Cyprus-Subsea/Smart-Cable-2-Hardware/modules/MCU/V1/VERSIONS.txt

α1:
Bugs:
1. Pin 26 connected to GND, should be VCC2_OUT.
