Cyprus-Subsea/Smart-Cable-2-Hardware/PINOUTS.xlsx

Sheet: STM32_CASES
 |  |  |  | PB9 | PB8 | PH3 | PB7 | PB6 | PB5 | PB4 | PB3 |  |  |  |  |  |  |  |  |  |  |  |  |  |  |  |  |  |  | PA15 | PA14
 |  |  |  | PB9 | PB8 | PH3 | PB7 | PB6 | PB5 | PB4 | PB3 |  |  |  |  |  |  |  |  |  |  |  |  |  |  | PD2 | PC12 | PC11 | PC10 | PA15 | PA14 |  |  |  |  | 144
 |  | PE1 | PE0 | PB9 | PB8 | PH3 | PB7 | PB6 | PB5 | PB4 | PB3 |  |  |  |  |  |  |  | PD7 | PD6 | PD5 | PD4 | PD3 | PD2 | PD1 | PD0 | PC12 | PC11 | PC10 | PA15 | PA14 |  |  |  |  | 100
 |  | PE1 | PE0 | PB9 | PB8 | PH3 | PB7 | PB6 | PB5 | PB4 | PB3 | PG15 | PG14 | PG13 | PG12 | PG11 | PG10 | PG9 | PD7 | PD6 | PD5 | PD4 | PD3 | PD2 | PD1 | PD0 | PC12 | PC11 | PC10 | PA15 | PA14 |  |  |  |  | 64
 |  |  |  |  |  |  |  |  |  |  |  |  |  |  |  |  |  |  |  |  |  |  |  |  |  |  |  |  |  |  |  | PA13 | PA13 | PA13 | PA13 | 48
 |  | PE2 | PE2 |  |  |  |  |  |  |  |  |  |  |  |  |  |  |  |  |  |  |  |  |  |  |  |  |  |  |  |  | PA12 | PA12 | PA12 | PA12
 |  | PE3 | PE3 |  |  |  |  |  |  |  |  |  |  |  |  |  |  |  |  |  |  |  |  |  |  |  |  |  |  |  |  | PA11 | PA11 | PA11 | PA11
 |  | PE4 | PE4 |  |  |  |  |  |  |  |  |  |  |  |  |  |  |  |  |  |  |  |  |  |  |  |  |  |  |  |  | PA10 | PA10 | PA10 | PA10
 |  | PE5 | PE5 |  |  |  |  |  |  |  |  |  |  |  |  |  |  |  |  |  |  |  |  |  |  |  |  |  |  |  |  | PA9 | PA9 | PA9 | PA9
 |  | PE6 | PE6 |  |  |  |  |  |  |  |  |  |  |  |  |  |  |  |  |  |  |  |  |  |  |  |  |  |  |  |  | PA8 | PA8 | PA8 | PA8
PC13 | PC13 | PC13 | PC13 |  |  |  |  |  |  |  |  |  |  |  |  |  |  |  |  |  |  |  |  |  |  |  |  |  |  |  |  | PC9 | PC9 | PC9
PC14 | PC14 | PC14 | PC14 |  |  |  |  |  |  |  |  |  |  |  |  |  |  |  |  |  |  |  |  |  |  |  |  |  |  |  |  | PC8 | PC8 | PC8
PC15 | PC15 | PC15 | PC15 |  |  |  |  |  |  |  |  |  |  |  |  |  |  |  |  |  |  |  |  |  |  |  |  |  |  |  |  | PC7 | PC7 | PC7
 |  |  | PF0 |  |  |  |  |  |  |  |  |  |  |  |  |  |  |  |  |  |  |  |  |  |  |  |  |  |  |  |  | PC6 | PC6 | PC6
 |  |  | PF1 |  |  |  |  |  |  |  |  |  |  |  |  |  |  |  |  |  |  |  |  |  |  |  |  |  |  |  |  | PG8
 |  |  | PF2 |  |  |  |  |  |  |  |  |  |  |  |  |  |  |  |  |  |  |  |  |  |  |  |  |  |  |  |  | PG7
 |  |  | PF3 |  |  |  |  |  |  |  |  |  |  |  |  |  |  |  |  |  |  |  |  |  |  |  |  |  |  |  |  | PG6
 |  |  | PF4 |  |  |  |  |  |  |  |  |  |  | STM32_LQFP CASES |  |  |  |  |  |  |  |  |  |  |  |  |  |  |  |  |  | PG5
 |  |  | PF5 |  |  |  |  |  |  |  |  |  |  |  |  |  |  |  |  |  |  |  |  |  |  |  |  |  |  |  |  | PG4
 |  |  | PF6 |  |  |  |  |  |  |  |  |  |  |  |  |  |  |  |  |  |  |  |  |  |  |  |  |  |  |  |  | PG3
 |  |  | PF7 |  |  |  |  |  |  |  |  |  |  |  |  |  |  |  |  |  |  |  |  |  |  |  |  |  |  |  |  | PG2
 |  |  | PF8 |  |  |  |  |  |  |  |  |  |  |  |  |  |  |  |  |  |  |  |  |  |  |  |  |  |  |  |  | PD15 | PD15
 |  |  | PF9 |  |  |  |  |  |  |  |  |  |  |  |  |  |  |  |  |  |  |  |  |  |  |  |  |  |  |  |  | PD14 | PD14
 |  |  | PF10 |  |  |  |  |  |  |  |  |  |  |  |  |  |  |  |  |  |  |  |  |  |  |  |  |  |  |  |  | PD13 | PD13
PH0 | PH0 | PH0 | PH0 |  |  |  |  |  |  |  |  |  |  |  |  |  |  |  |  |  |  |  |  |  |  |  |  |  |  |  |  | PD12 | PD12
PH1 | PH1 | PH1 | PH1 |  |  |  |  |  |  |  |  |  |  |  |  |  |  |  |  |  |  |  |  |  |  |  |  |  |  |  |  | PD11 | PD11
 | PC0 | PC0 | PC0 |  |  |  |  |  |  |  |  |  |  |  |  |  |  |  |  |  |  |  |  |  |  |  |  |  |  |  |  | PD10 | PD10
 | PC1 | PC1 | PC1 |  |  |  |  |  |  |  |  |  |  |  |  |  |  |  |  |  |  |  |  |  |  |  |  |  |  |  |  | PD9 | PD9
 | PC2 | PC2 | PC2 |  |  |  |  |  |  |  |  |  |  |  |  |  |  |  |  |  |  |  |  |  |  |  |  |  |  |  |  | PD8 | PD8
 | PC3 | PC3 | PC3 |  |  |  |  |  |  |  |  |  |  |  |  |  |  |  |  |  |  |  |  |  |  |  |  |  |  |  |  | PB15 | PB15 | PB15 | PB15
PA0 | PA0 | PA0 | PA0 |  |  |  |  |  |  |  |  |  |  |  |  |  |  |  |  |  |  |  |  |  |  |  |  |  |  |  |  | PB14 | PB14 | PB14 | PB14
PA1 | PA1 | PA1 | PA1 |  |  |  |  |  |  |  |  |  |  |  |  |  |  |  |  |  |  |  |  |  |  |  |  |  |  |  |  | PB13 | PB13 | PB13 | PB13
PA2 | PA2 | PA2 | PA2 |  |  |  |  |  |  |  |  |  |  |  |  |  |  |  |  |  |  |  |  |  |  |  |  |  |  |  |  | PB12 | PB12 | PB12 | PB12
 |  |  |  | PA3 | PA4 | PA5 | PA6 | PA7 | PC4 | PC5 | PB0 | PB1 | PB2 | PF11 | PF12 | PF13 | PF14 | PF15 | PG0 | PG1 | PE7 | PE8 | PE9 | PE10 | PE11 | PE12 | PE13 | PE14 | PE15 | PB10 | PB11
 |  |  |  | PA3 | PA4 | PA5 | PA6 | PA7 | PC4 | PC5 | PB0 | PB1 | PB2 |  |  |  |  |  |  |  | PE7 | PE8 | PE9 | PE10 | PE11 | PE12 | PE13 | PE14 | PE15 | PB10 | PB11
 |  |  |  | PA3 | PA4 | PA5 | PA6 | PA7 | PC4 | PC5 | PB0 | PB1 | PB2 |  |  |  |  |  |  |  |  |  |  |  |  |  |  |  |  | PB10 | PB11
 |  |  |  | PA3 | PA4 | PA5 | PA6 | PA7 |  |  | PB0 | PB1 | PB2 |  |  |  |  |  |  |  |  |  |  |  |  |  |  |  |  | PB10 | PB11

Sheet: STM32L552_PINS
MCU α1 | MB α1 |  | Analog,additional function | USART1/2/3 | UART4/5/LPUA RT1/SDMMC1 | I2C1/2/3/4 | SPI1/2/3/I2C4/ DFSDM1/ OCTOSPI1 | SPI3/I2C3/DFS DM1/COMP1/ | SPI2/SAI1/I2C4/ USART2/TIM1/8/ OCTOSPI1 | FDCAN1/ TSC | USB/OCTOSPI1 | TIM2/8/15/16/17/ LPTIM2 | TIM1/2/5/8/L PTIM1 | TIM1/2/3/4/5/ LPTIM3 | SAI1/2/TIM8 | SDMMC1/COMP1 /2/TIM1/8/FMC | UCPD1 | SYS_AF | EVENTOUT
89 | H5_6 | PA0 | ADC,WKP1 TAMP,OAMP1_INP | USART2_CTS_ NSS | UART4_TX | - | - | - | TIM8_ETR | - | - | TIM2_ETR | TIM2_CH1 | TIM5_CH1 | SAI1_EXTCLK | - | - | - | EVENTOUT | H2_6 | H3_6 | H4_6 | H5_6
88 | H5_7 | PA1 | ADC,WKP1 TAMP,OAMP1_INM | USART2_RTS_ DE | UART4_RX | I2C1_SMBA | SPI1_SCK | - | - | - | OCTOSPI1_DQS | TIM15_CH1N | TIM2_CH2 | TIM5_CH2 | - | - | - | - | EVENTOUT | H2_7 | H3_7 | H4_7 | H5_7
87 | H2_6 | PA2 | ADC,WKP,COMP1_INP | USART2_TX | LPUART1_TX | - | - | - | - | - | OCTOSPI1_NCS | TIM15_CH1 | TIM2_CH3 | TIM5_CH3 | SAI2_EXTCLK | - | UCPD1_FRSTX1 | - | EVENTOUT
86 | H2_7 | PA3 | ADC,OPAMP1_OUT | USART2_RX | LPUART1_RX | - | - | - | SAI1_CK1 | - | OCTOSPI1_CLK | TIM15_CH2 | TIM2_CH4 | TIM5_CH4 | SAI1_MCLK_A | - | - | - | EVENTOUT | H2_15 | H3_15 | H4_15 | H5_15
85 | H2_19 | PA4 | ADC,DAC_OUT1 | USART2_CK | - | - | SPI1_NSS | SPI3_NSS | OCTOSPI1_NCS | - | - | LPTIM2_OUT | - | - | SAI1_FS_B | - | - | - | EVENTOUT | H2_16 | H3_16 | H4_16 | H5_16
84 | H2-5_12 | PA5 | ADC,DAC_OUT2 | - | - | - | SPI1_SCK | - | TIM8_CH1N | - | - | LPTIM2_ETR | TIM2_CH1 | TIM2_ETR | - | - | - | - | EVENTOUT | H2_17 | H3_17 | H4_17 | H5_17
83 | H2-5_13 | PA6 | ADC,OPAMP2_VINP | USART3_CTS_ NSS | LPUART1_CTS _NSS | - | SPI1_MISO | - | TIM8_BKIN | - | OCTOSPI1_IO3 | TIM16_CH1 | TIM1_BKIN | TIM3_CH1 | TIM8_BKIN | TIM1_BKIN | - | - | EVENTOUT | H2_18 | H3_18 | H4_18 | H5_18
82 | H2-5_14 | PA7 | ADC,OPAMP2_VINM | - | - | I2C3_SCL | SPI1_MOSI | - | TIM8_CH1N | - | OCTOSPI1_IO2 | TIM17_CH1 | TIM1_CH1N | TIM3_CH2 | - | - | - | - | EVENTOUT | H2_19 | H3_19 | H4_19 | H5_19
40 | H3_15 | PA8 |  | USART1_CK | - | - | - | - | SAI1_CK2 | - | - | LPTIM2_OUT | TIM1_CH1 | - | SAI1_SCK_A | - | - | MCO | EVENTOUT
39 | H4_6 | PA9 |  | USART1_TX | - | - | - | - | SPI2_SCK | - | - | TIM15_BKIN | TIM1_CH2 | - | SAI1_FS_A | - | - | - | EVENTOUT
38 | H4_7 | PA10 |  | USART1_RX | - | - | - | - | SAI1_D1 | - | CRS_SYNC | TIM17_BKIN | TIM1_CH3 | - | SAI1_SD_A | - | - | - | EVENTOUT
37 | H4_18 | PA11 |  | USART1_CTS_ NSS | - | - | SPI1_MISO | - | - | FDCAN1_ RX | USB_DM | - | TIM1_CH4 | TIM1_BKIN2 | - | TIM1_BKIN2 | - | - | EVENTOUT
36 | H4_19 | PA12 |  | USART1_RTS_ DE | - | - | SPI1_MOSI | - | - | FDCAN1_ TX | USB_DP | - | TIM1_ETR | - | - | - | - | - | EVENTOUT
35 |  | PA13 |  | - | - | - | - | - | - | - | USB_NOE | - | IR_OUT | - | SAI1_SD_B | - | - | JTMS/SWDIO | EVENTOUT
34 |  | PA14 |  | - | - | I2C1_SMBA | I2C4_SMBA | - | - | - | - | - | LPTIM1_OUT | - | SAI1_FS_B | - | - | JTCK/SWCLK | EVENTOUT
SD_CD1 |  | PA15 |  | USART3_RTS_ DE | UART4_RTS_D E | - | SPI1_NSS | SPI3_NSS | USART2_RX | - | - | - | TIM2_CH1 | TIM2_ETR | SAI2_FS_B | - | - | JTDI | EVENTOUT
79 | H2_15 | PB0 | ADC,OPAMP2_OUT | USART3_CK | - | - | SPI1_NSS | - | TIM8_CH2N | - | OCTOSPI1_IO1 | - | TIM1_CH2N | TIM3_CH3 | SAI1_EXTCLK | COMP1_OUT | - | - | EVENTOUT |  | H2-5_8 | H3-4_8 | H2-5_12 | H3-4_12
78 | H2_16 | PB1 | ADC,COMP1_INM | USART3_RTS_ DE | LPUART1_RTS_ DE | - | - | DFSDM1_DATI N0 | TIM8_CH3N | - | OCTOSPI1_IO0 | LPTIM2_IN1 | TIM1_CH3N | TIM3_CH4 | - | - | - | - | EVENTOUT |  | H2-5_9 | H3-4_9 | H2-5_13 | H3-4_13
77 |  | PB2 | RTC_OUT2,COMP1_INP | - | - | I2C3_SMBA | - | DFSDM1_CKI N0 | - | - | OCTOSPI1_DQS | - | LPTIM1_OUT | - | - | - | UCPD1_FRSTX1 | - | EVENTOUT |  |  |  | H2-5_14 | H3-4_14
17 | PWRM_I2C_PILLUP | PB3 | COMP2_INM | USART1_RTS_ DE | - | - | SPI1_SCK | SPI3_SCK | - | - | CRS_SYNC | - | TIM2_CH2 | - | SAI1_SCK_B | - | - | JTDO/TRACE SWO | EVENTOUT
16 |  | PB4 | COMP2_INP | USART1_CTS_ NSS | UART5_RTS_D E | I2C3_SDA | SPI1_MISO | SPI3_MISO | - | TSC_G2_ IO1 | - | TIM17_BKIN | - | TIM3_CH1 | SAI1_MCLK_B | - | - | NJTRST | EVENTOUT
15 |  | PB5 |  | USART1_CK | UART5_CTS_N SS | I2C1_SMBA | SPI1_MOSI | SPI3_MOSI | OCTOSPI1_NCLK | TSC_G2_ IO2 | - | TIM16_BKIN | LPTIM1_IN1 | TIM3_CH2 | SAI1_SD_B | COMP2_OUT | - | - | EVENTOUT
14 | H3-4_8 | PB6 | COMP2_INP | USART1_TX | - | I2C1_SCL | I2C4_SCL | - | TIM8_BKIN2 | TSC_G2_ IO3 | - | TIM16_CH1N | LPTIM1_ETR | TIM4_CH1 | SAI1_FS_B | TIM8_BKIN2 | - | - | EVENTOUT
13 | H3-4_9 | PB7 | COMP2_INM | USART1_RX | UART4_CTS_N SS | I2C1_SDA | I2C4_SDA | - | TIM8_BKIN | TSC_G2_ IO4 | - | TIM17_CH1N | LPTIM1_IN2 | TIM4_CH2 | TIM8_BKIN | FMC_NL | - | - | EVENTOUT
12 | H3_18 | PB8 |  | - | SDMMC1_CKIN | I2C1_SCL | DFSDM1_CKOU T | - | SAI1_CK1 | FDCAN1_ RX | - | TIM16_CH1 | - | TIM4_CH3 | SAI1_MCLK_A | SDMMC1_D4 | - | - | EVENTOUT
11 | H3_19 | PB9 |  | - | SDMMC1_CDIR | I2C1_SDA | SPI2_NSS | - | SAI1_D2 | FDCAN1_ TX | - | TIM17_CH1 | IR_OUT | TIM4_CH4 | SAI1_FS_A | SDMMC1_D5 | - | - | EVENTOUT
65 | PWR UART-UP/I2C-NORMLRMAL | PB10 |  | USART3_TX | LPUART1_RX | I2C2_SCL | SPI2_SCK | - | I2C4_SCL | TSC_SY NC | OCTOSPI1_CLK | - | TIM2_CH3 | LPTIM3_OUT | SAI1_SCK_A | COMP1_OUT | - | - | EVENTOUT | PWR UART-UP/I2C-NORMLRMAL
64 |  | PB11 |  | USART3_RX | LPUART1_TX | I2C2_SDA | - | - | I2C4_SDA | - | OCTOSPI1_NCS | - | TIM2_CH4 | - | - | COMP2_OUT | - | - | EVENTOUT
63 |  | PB12 |  | USART3_CK | LPUART1_RTS_ DE | I2C2_SMBA | SPI2_NSS | DFSDM1_DATI N1 | TIM1_BKIN | TSC_G1_ IO1 | OCTOSPI1_NCLK | TIM15_BKIN | TIM1_BKIN | - | SAI2_FS_A | - | - | - | EVENTOUT | PWR BOOTLOADER
62 | H3_16 | PB13 |  | USART3_CTS_ NSS | LPUART1_CTS _NSS | I2C2_SCL | SPI2_SCK | DFSDM1_CKI N1 | - | TSC_G1_ IO2 | - | TIM15_CH1N | TIM1_CH1N | LPTIM3_IN1 | SAI2_SCK_A | - | UCPD1_FRSTX2 | - | EVENTOUT
61 | H3_17 | PB14 |  | USART3_RTS_ DE | - | I2C2_SDA | SPI2_MISO | DFSDM1_DATI N2 | TIM8_CH2N | TSC_G1_ IO3 | - | TIM15_CH1 | TIM1_CH2N | LPTIM3_ETR | SAI2_MCLK_A | - | - | - | EVENTOUT
60 |  | PB15 |  | - | - | - | SPI2_MOSI | DFSDM1_CKI N2 | TIM8_CH3N | - | - | TIM15_CH2 | TIM1_CH3N | - | SAI2_SD_A | - | - | RTC_REFIN | EVENTOUT
93 | H5_19 | PC0 | ADC | - | LPUART1_RX | I2C3_SCL | - | - | OCTOSPI1_IO7 | - | - | LPTIM2_IN1 | LPTIM1_IN1 | - | SAI2_FS_A | SDMMC1_D5 | - | - | EVENTOUT
92 | H5_18 | PC1 | ADC | - | LPUART1_TX | I2C3_SDA | - | - | SPI2_MOSI | - | OCTOSPI1_IO4 | - | LPTIM1_OUT | - | SAI1_SD_A | - | - | TRACED0 | EVENTOUT
91 | H2_17 | PC2 | ADC | - | - | - | SPI2_MISO | DFSDM1_CKO UT | - | TSC_G3_ IO1 | OCTOSPI1_IO5 | - | LPTIM1_IN2 | - | - | - | - | - | EVENTOUT
90 | H2_18 | PC3 | ADC | - | - | - | SPI2_MOSI | - | SAI1_D1 | TSC_G1_ IO4 | OCTOSPI1_IO6 | LPTIM2_ETR | LPTIM1_ETR | LPTIM3_OUT | SAI1_SD_A | - | - | - | EVENTOUT
81 | H3_6 | PC4 | ADC,COMP1_INM | USART3_TX | - | - | - | - | - | - | OCTOSPI1_IO7 | - | - | - | - | - | - | - | EVENTOUT
80 | H3_7 | PC5 | ADC,COMP1_INP,WKUP | USART3_RX | - | - | - | - | SAI1_D3 | - | - | - | - | - | - | - | - | - | EVENTOUT
42 |  | PC6 |  | - | SDMMC1_D0DI R | - | - | DFSDM1_CKI N3 | TIM8_CH1 | TSC_G4_ IO1 | - | - | - | TIM3_CH1 | SAI2_MCLK_A | SDMMC1_D6 | - | - | EVENTOUT
41 |  | PC7 |  | - | SDMMC1_D123 DIR | - | - | DFSDM1_DATI N3 | TIM8_CH2 | TSC_G4_ IO2 | - | - | - | TIM3_CH2 | SAI2_MCLK_B | SDMMC1_D7 | - | - | EVENTOUT
SD_DAT0 |  | PC8 |  | - | - | - | - | - | TIM8_CH3 | TSC_G4_ IO3 | - | - | - | TIM3_CH3 | - | SDMMC1_D0 | - | - | EVENTOUT
SD_DAT1 |  | PC9 |  | - | - | - | - | - | TIM8_CH4 | TSC_G4_ IO4 | USB_NOE | TIM8_BKIN2 | TIM8_BKIN2 | TIM3_CH4 | SAI2_EXTCLK | SDMMC1_D1 | - | TRACED0 | EVENTOUT
SD_DAT2 |  | PC10 |  | USART3_TX | UART4_TX | - | - | SPI3_SCK | - | TSC_G3_ IO2 | - | - | - | LPTIM3_ETR | SAI2_SCK_B | SDMMC1_D2 | - | TRACED1 | EVENTOUT
SD_DAT3 |  | PC11 |  | USART3_RX | UART4_RX | - | OCTOSPI1_NCS | SPI3_MISO | - | TSC_G3_ IO3 | - | - | - | LPTIM3_IN1 | SAI2_MCLK_B | SDMMC1_D3 | UCPD1_FRSTX2 | - | EVENTOUT
SD_CLK |  | PC12 |  | USART3_CK | UART5_TX | - | - | SPI3_MOSI | - | TSC_G3_ IO4 | - | - | - | - | SAI2_SD_B | SDMMC1_CK | - | TRACED3 | EVENTOUT
3 |  | PC13 |  | - | - | - | - | - | - | - | - | - | - | - | - | - | - | - | EVENTOUT
OSC32_IN |  | PC14 |  | - | - | - | - | - | - | - | - | - | - | - | - | - | - | - | EVENTOUT
OSC32_OUT |  | PC15 |  | - | - | - | - | - | - | - | - | - | - | - | - | - | - | - | EVENTOUT
33 |  | PD0 |  | - | - | - | SPI2_NSS | - | - | FDCAN1_ RX | - | - | - | - | - | FMC_D2 | - | - | EVENTOUT
32 | H3-4_12 | PD1 |  | - | - | - | SPI2_SCK | - | - | FDCAN1_ TX | - | - | - | - | - | FMC_D3 | - | - | EVENTOUT
SD_CMD |  | PD2 |  | USART3_RTS_ DE | UART5_RX | - | - | - | - | TSC_SY NC | - | - | - | TIM3_ETR | - | SDMMC1_CMD | - | TRACED2 | EVENTOUT
31 | H3-4_13 | PD3 |  | USART2_CTS_ NSS | - | - | SPI2_MISO | DFSDM1_DATI N0 | SPI2_SCK | - | - | - | - | - | - | FMC_CLK | - | - | EVENTOUT
30 | H3-4_14 | PD4 |  | USART2_RTS_ DE | - | - | SPI2_MOSI | DFSDM1_CKI N0 | - | - | OCTOSPI1_IO4 | - | - | - | - | FMC_NOE | - | - | EVENTOUT
29 |  | PD5 |  | USART2_TX | - | - | - | - | - | - | OCTOSPI1_IO5 | - | - | - | - | FMC_NWE | - | - | EVENTOUT
28 |  | PD6 |  | USART2_RX | - | - | SPI3_MOSI | DFSDM1_DATI N1 | SAI1_D1 | - | OCTOSPI1_IO6 | - | - | - | SAI1_SD_A | FMC_NWAIT | - | - | EVENTOUT
27 |  | PD7 |  | USART2_CK | - | - | - | DFSDM1_CKI N1 | - | - | OCTOSPI1_IO7 | - | - | - | - | FMC_NCE/FMC_ NE1 | - | - | EVENTOUT
59 |  | PD8 |  | USART3_TX | - | - | - | - | - | - | - | - | - | - | - | FMC_D13 | - | - | EVENTOUT
58 |  | PD9 |  | USART3_RX | - | - | - | - | - | - | - | - | - | - | SAI2_MCLK_A | FMC_D14 | - | - | EVENTOUT
57 |  | PD10 |  | USART3_CK | - | - | - | - | - | TSC_G6_ IO1 | - | - | - | - | SAI2_SCK_A | FMC_D15 | - | - | EVENTOUT
56 |  | PD11 |  | USART3_CTS_ NSS | - | I2C4_SMBA | - | - | - | TSC_G6_ IO2 | - | LPTIM2_ETR | - | - | SAI2_SD_A | FMC_A16 | - | - | EVENTOUT
55 | H2-5_8 | PD12 |  | USART3_RTS_ DE | - | I2C4_SCL | - | - | - | TSC_G6_ IO3 | - | LPTIM2_IN1 | - | TIM4_CH1 | SAI2_FS_A | FMC_A17 | - | - | EVENTOUT
54 | H2-5_9 | PD13 |  | - | - | I2C4_SDA | - | - | - | TSC_G6_ IO4 | - | LPTIM2_OUT | - | TIM4_CH2 | - | FMC_A18 | - | - | EVENTOUT
53 |  | PD14 |  | - | - | - | - | - | - | - | - | - | - | TIM4_CH3 | - | FMC_D0 | - | - | EVENTOUT
52 |  | PD15 |  | - | - | - | - | - | - | - | - | - | - | TIM4_CH4 | - | FMC_D1 | - | - | EVENTOUT
10 |  | PE0 |  | - | - | - | - | - | - | - | - | TIM16_CH1 | - | TIM4_ETR | - | FMC_NBL0 | - | - | EVENTOUT
9 |  | PE1 |  | - | - | - | - | - | - | - | - | TIM17_CH1 | - | - | - | FMC_NBL1 | - | - | EVENTOUT
8 |  | PE2 |  | - | - | - | - | - | SAI1_CK1 | TSC_G7_ IO1 | - | - | - | TIM3_ETR | SAI1_MCLK_A | FMC_A23 | - | TRACECK | EVENTOUT
7 | PWR BOOTLOADER | PE3 |  | - | - | - | - | - | OCTOSPI1_DQS | TSC_G7_ IO2 | - | - | - | TIM3_CH1 | SAI1_SD_B | FMC_A19 | - | TRACED0 | EVENTOUT
6 | H4_15 | PE4 |  | - | - | - | - | DFSDM1_DATI N3 | SAI1_D2 | TSC_G7_ IO3 | - | - | - | TIM3_CH2 | SAI1_FS_A | FMC_A20 | - | TRACED1 | EVENTOUT
5 | H4_16 | PE5 |  | - | - | - | - | DFSDM1_CKI N3 | SAI1_CK2 | TSC_G7_ IO4 | - | - | - | TIM3_CH3 | SAI1_SCK_A | FMC_A21 | - | TRACED2 | EVENTOUT
4 | H4_17 | PE6 |  | - | - | - | - | - | SAI1_D1 | - | - | - | - | TIM3_CH4 | SAI1_SD_A | FMC_A22 | - | TRACED3 | EVENTOUT
68 | H5_15 | PE7 |  | - | - | - | - | DFSDM1_DATI N2 | - | - | - | - | TIM1_ETR | - | SAI1_SD_B | FMC_D4 | - | - | EVENTOUT
67 | H5_16 | PE8 |  | - | - | - | - | DFSDM1_CKI N2 | - | - | - | - | TIM1_CH1N | - | SAI1_SCK_B | FMC_D5 | - | - | EVENTOUT
66 | H5_17 | PE9 |  | - | - | - | - | DFSDM1_CKO UT | - | - | OCTOSPI1_NCLK | - | TIM1_CH1 | - | SAI1_FS_B | FMC_D6 | - | - | EVENTOUT
QSPI_CLK |  | PE10 |  | - | - | - | - | - | - | TSC_G5_ IO1 | OCTOSPI1_CLK | - | TIM1_CH2N | - | SAI1_MCLK_B | FMC_D7 | - | - | EVENTOUT
QSPI_CS |  | PE11 |  | - | - | - | - | - | - | TSC_G5_ IO2 | OCTOSPI1_NCS | - | TIM1_CH2 | - | - | FMC_D8 | - | - | EVENTOUT
QSPI_D0 |  | PE12 |  | - | - | - | SPI1_NSS | - | - | TSC_G5_ IO3 | OCTOSPI1_IO0 | - | TIM1_CH3N | - | - | FMC_D9 | - | - | EVENTOUT
QSPI_D1 |  | PE13 |  | - | - | - | SPI1_SCK | - | - | TSC_G5_ IO4 | OCTOSPI1_IO1 | - | TIM1_CH3 | - | - | FMC_D10 | - | - | EVENTOUT
QSPI_D2 |  | PE14 |  | - | - | - | SPI1_MISO | - | TIM1_BKIN2 | - | OCTOSPI1_IO2 | - | TIM1_CH4 | TIM1_BKIN2 | - | FMC_D11 | - | - | EVENTOUT
QSPI_D3 |  | PE15 |  | - | - | - | SPI1_MOSI | - | TIM1_BKIN | - | OCTOSPI1_IO3 | - | TIM1_BKIN | - | - | FMC_D12 | - | - | EVENTOUT

Sheet: MB α1 pinouts
 |  | Standard module | MCU α1 pin | RS232-2 α1 pin | IMU α1 | DIRECT I2C α1
H2 | 2 |  |  | RS232_B_RX
 | 3 | S3_3 |  | RS232_B_TX
 | 4 | S3_2 |  | RS232_A_RX |  | I2C_SDA_OUT
 | 5 | S3_1 |  | RS232_A_TX |  | I2C_SCL_OUT
 | 6 | USART2/TX | PA2 | UART_A_TTL_TX | ΙΝΤ1
 | 7 | USART2/RX | PA3 | UART_A_TTL_RX | ΙΝΤ2
 | 8 | I2C4_SCL | PD12 |  | I2C_SCL | I2C_SCL
 | 9 | I2C4_SDA | PD13 |  | I2C_SDA | I2C_SDA
 | 12 | SPI1_SCK | PA5
 | 13 | SPI1_MISO | PA6
 | 14 | SPI1_MOSI | PA7
 | 15 | GPIO | PB0 | UART_A_FORCEON
 | 16 | GPIO | PB1 | UART_B_FORCEON
 | 17 | ADC | PC2
 | 18 | ADC | PC3 | UART_B_TTL_TX
 | 19 | USART2_CK | PA4 | UART_B_TTL_RX
H3 | 2 | S5_4 |  | RS232_B_RX
 | 3 | S5_3 |  | RS232_B_TX
 | 4 | S5_2 |  | RS232_A_RX |  | I2C_SDA_OUT
 | 5 | S5_1 |  | RS232_A_TX |  | I2C_SCL_OUT
 | 6 | USART3/TX | PC4 | UART_A_TTL_TX | ΙΝΤ1
 | 7 | USART3/RX | PC5 | UART_A_TTL_RX | ΙΝΤ2
 | 8 | I2C1_SCL | PB6 |  | I2C_SCL | I2C_SCL
 | 9 | I2C1_SDA | PB7 |  | I2C_SDA | I2C_SDA
 | 12 | SPI2_SCK | PD1
 | 13 | SPI2_MISO | PD3
 | 14 | SPI2_MOSI | PD4
 | 15 | MCO | PA8 | UART_A_FORCEON
 | 16 | USART3_CTS_ NSS | PB13 | UART_B_FORCEON
 | 17 | USART3_RTS_ DE | PB14
 | 18 | FDCAN1_ RX | PB8 | UART_B_TTL_TX
 | 19 | FDCAN1_ TX | PB9 | UART_B_TTL_RX
H4 | 2 | S1_4 |  | RS232_B_RX
 | 3 | S1_3 |  | RS232_B_TX
 | 4 | S1_2 |  | RS232_A_RX |  | I2C_SDA_OUT
 | 5 | S1_1 |  | RS232_A_TX |  | I2C_SCL_OUT
 | 6 | USART1/TX | PA9 | UART_A_TTL_TX | ΙΝΤ1
 | 7 | USART1/RX | PA10 | UART_A_TTL_RX | ΙΝΤ2
 | 8 | I2C1_SCL | PB6 |  | I2C_SCL | I2C_SCL
 | 9 | I2C1_SDA | PB7 |  | I2C_SDA | I2C_SDA
 | 12 | SPI2_SCK | PD1
 | 13 | SPI2_MISO | PD3
 | 14 | SPI2_MOSI | PD4
 | 15 | SAI1_FS_A | PE4 | UART_A_FORCEON
 | 16 | SAI1_SCK_A | PE5 | UART_B_FORCEON
 | 17 | SAI1_SD_A | PE6
 | 18 | USB_DM | PA11 | UART_B_TTL_TX
 | 19 | USB_DP | PA12 | UART_B_TTL_RX
H5 | 2 | S2_2 |  | RS232_B_RX
 | 3 | S2_1 |  | RS232_B_TX
 | 4 | S4_2 |  | RS232_A_RX |  | I2C_SDA_OUT
 | 5 | S4_1 |  | RS232_A_TX |  | I2C_SCL_OUT
 | 6 | UART4/TX | PA0 | UART_A_TTL_TX | ΙΝΤ1
 | 7 | UART4/RX | PA1 | UART_A_TTL_RX | ΙΝΤ2
 | 8 | I2C4_SCL | PD12 |  | I2C_SCL | I2C_SCL
 | 9 | I2C4_SDA | PD13 |  | I2C_SDA | I2C_SDA
 | 12 | SPI1_SCK | PA5
 | 13 | SPI1_MISO | PA6
 | 14 | SPI1_MOSI | PA7
 | 15 | DFSDM1_DATI N2 | PE7 | UART_A_FORCEON
 | 16 | DFSDM1_CKI N2 | PE8 | UART_B_FORCEON
 | 17 | DFSDM1_CKO UT | PE9
 | 18 | LPUART1_TX | PC1 | UART_B_TTL_TX
 | 19 | LPUART1_RX | PC0 | UART_B_TTL_RX
POWER CONTROL MCU
 |  | PWRM_I2C_PILLUP | PB3
 |  | PWR UART-UPL/I2C-NORM | PB10
 |  |  | PB11
 |  | PWR BOOTLOADER | PE3
