Cyprus-Subsea/Smart-Cable-2-Hardware/modules/MCU/α2/MCU_α2.kicad_pcb

## KiCad design modules/MCU/α2/MCU_α2.kicad_pcb (2023-06-07)

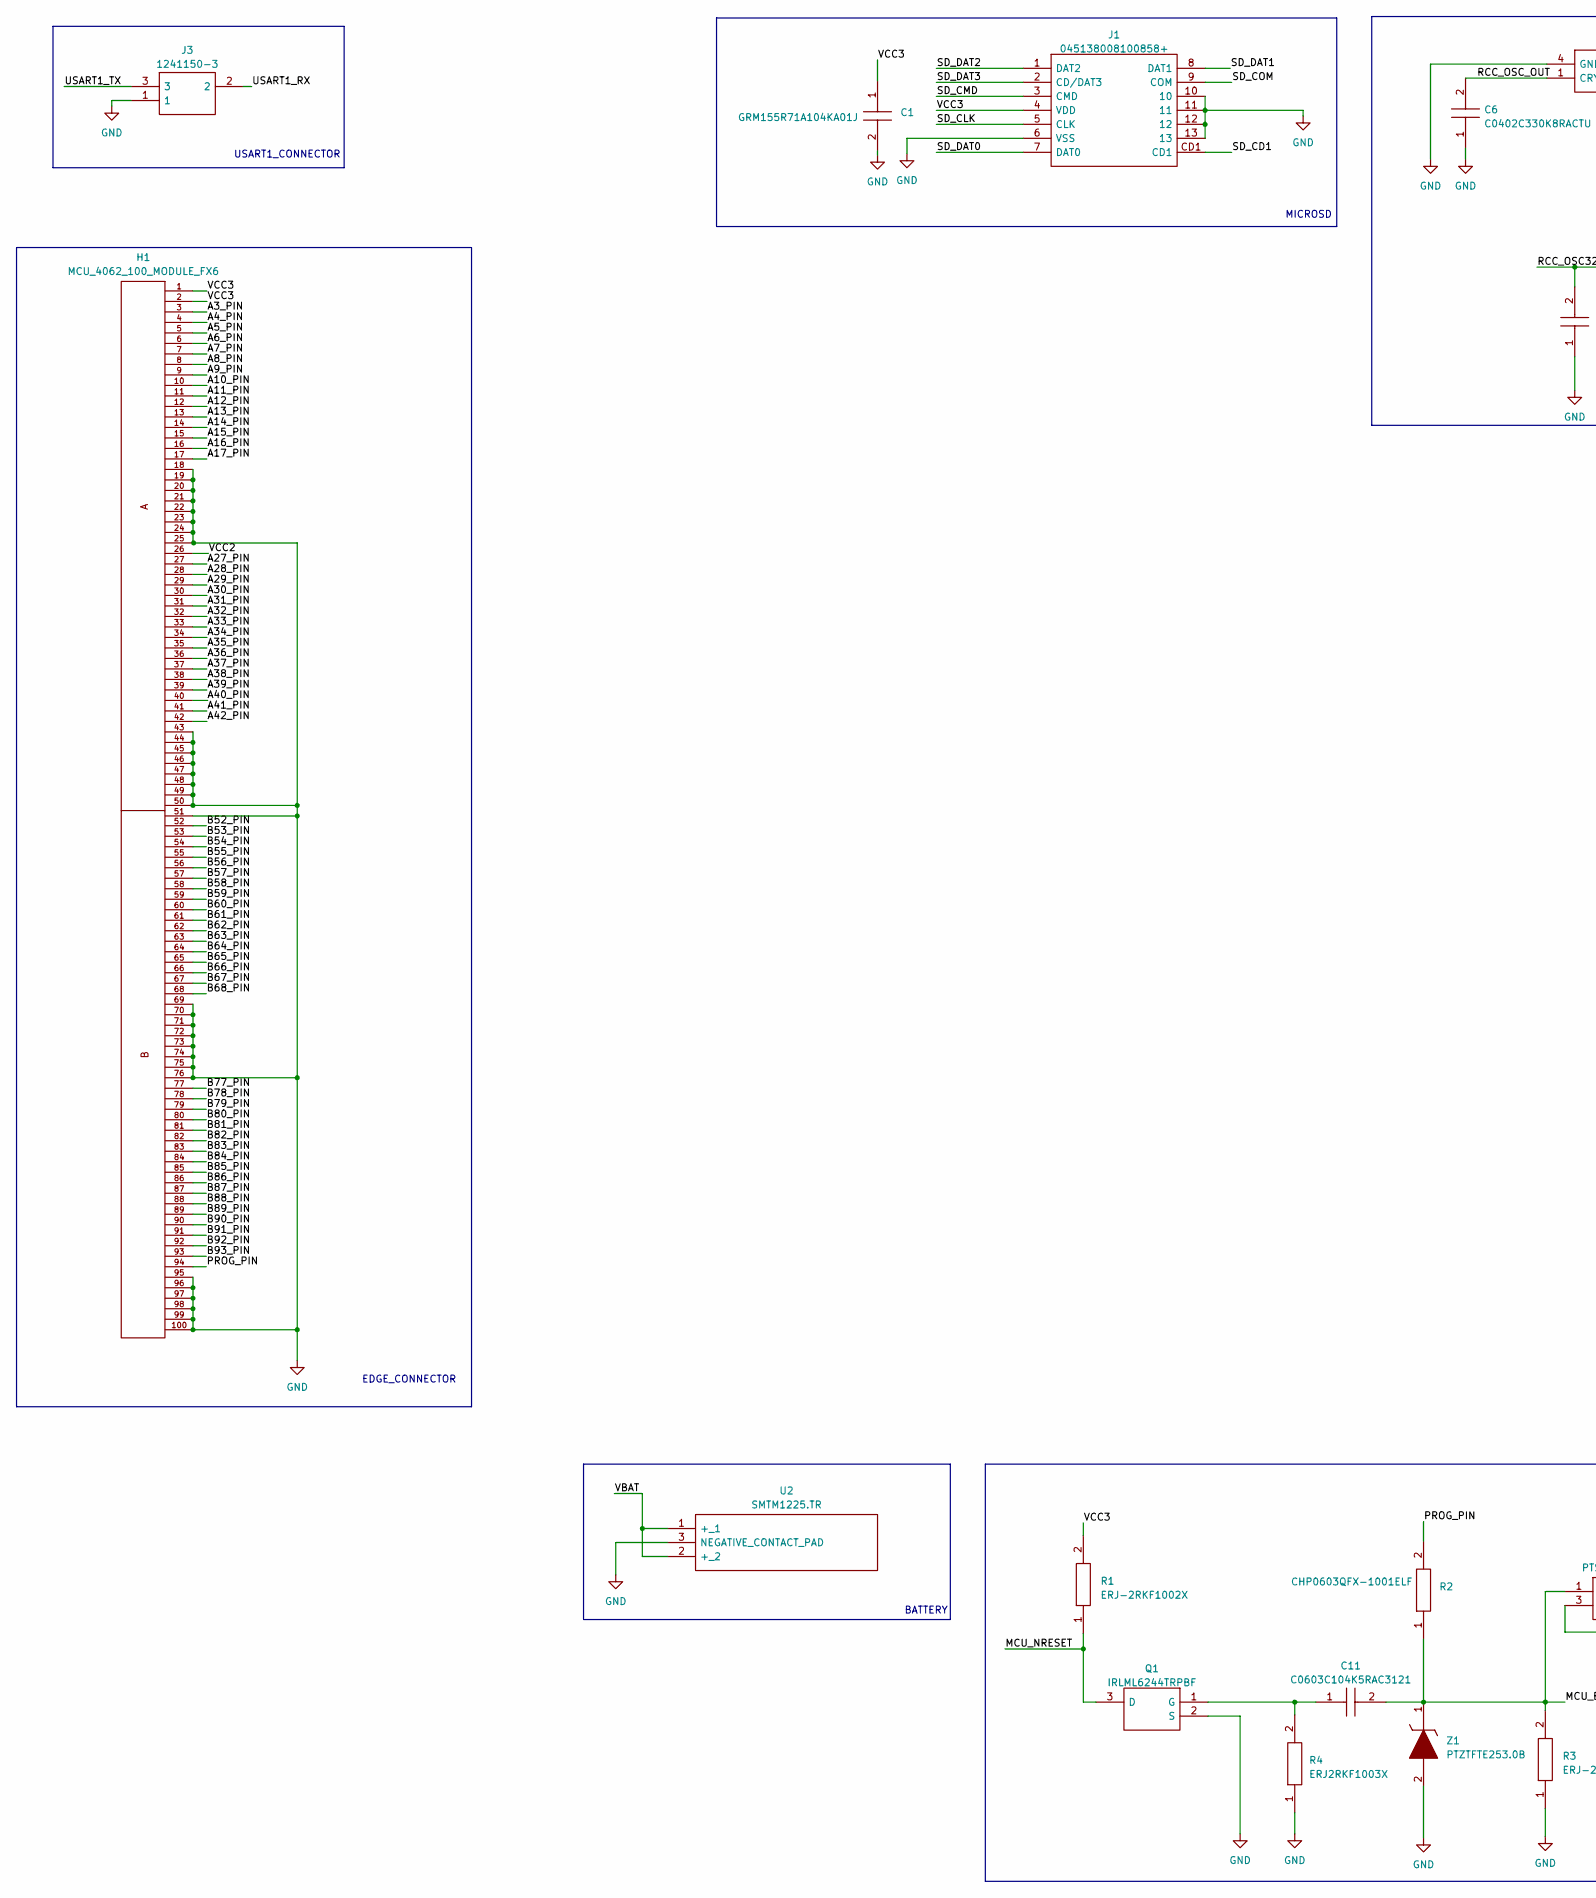
[picture p1: schematic MCU_α2.kicad_sch, part in row 1, column 1]

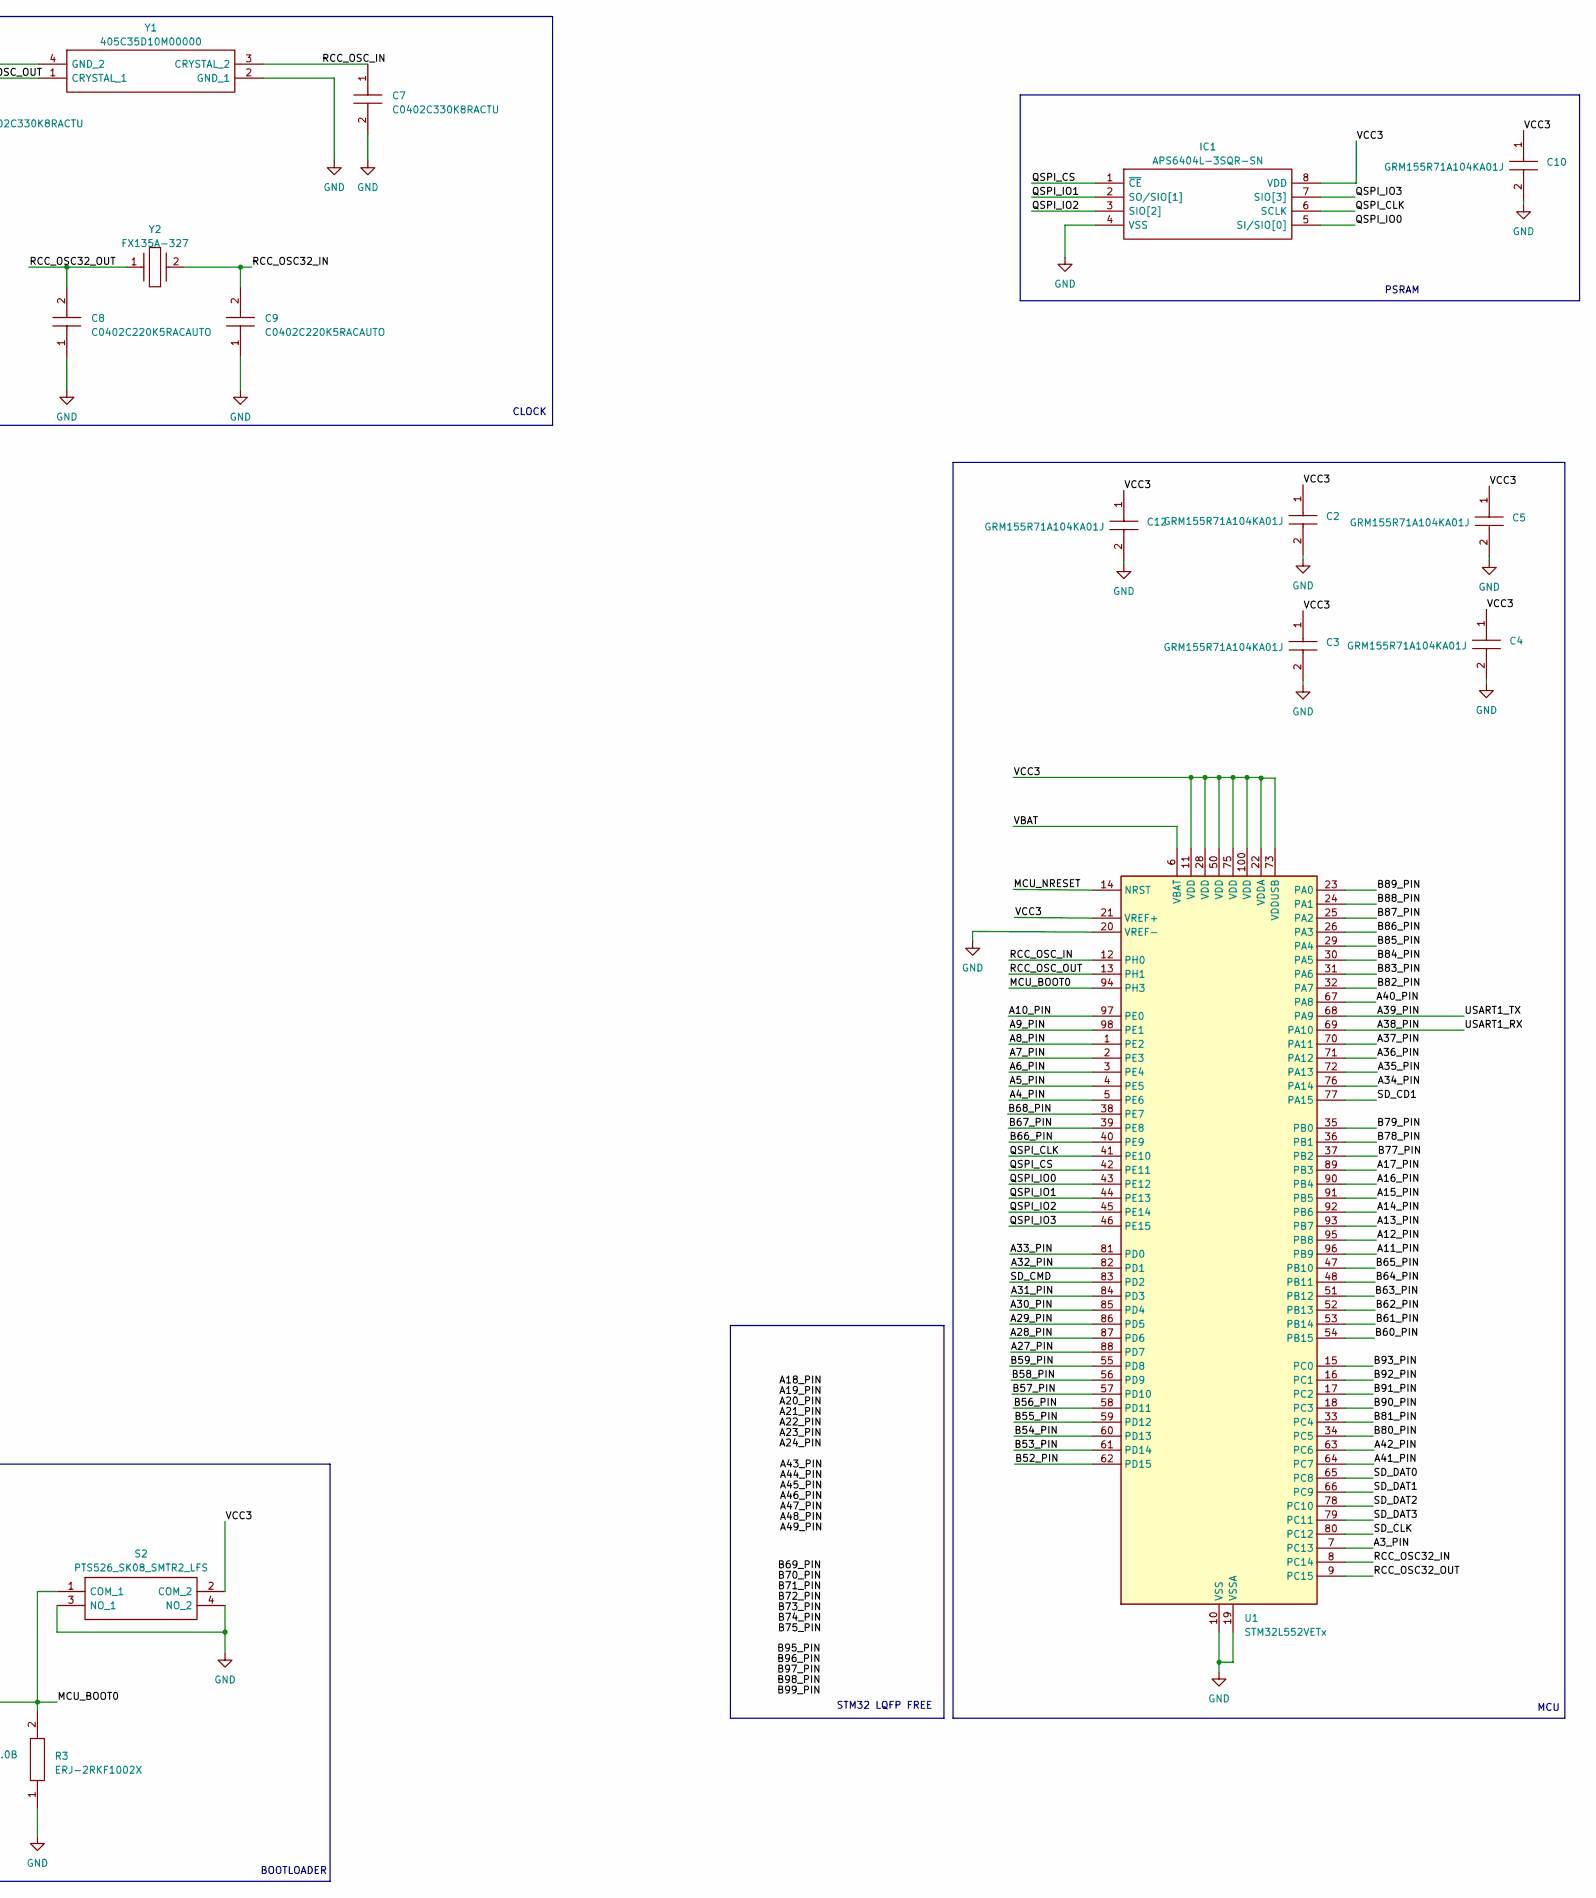
[picture p2: schematic MCU_α2.kicad_sch, part in row 1, column 2]

Parts:
C1, C2, C3, C4, C5, C10, C12: GRM155R71A104KA01J; CAPC1005X55N; Manufacturer_Part_Number GRM155R71A104KA01J; Mouser Part Number 81-GRM155R71A104KA1J
C6, C7: C0402C330K8RACTU; CAPC1005X55N; Manufacturer_Part_Number C0402C330K8RACTU; Mouser Part Number 80-C0402C330K8RACTU
C8, C9: C0402C220K5RACAUTO; C0402; Manufacturer_Part_Number C0402C220K5RACAUTO; Mouser Part Number 80-C0402C220K5RAUTO
C11: C0603C104K5RAC3121; CAPC1608X95N; Manufacturer_Part_Number C0603C104K5RAC3121; Mouser Part Number 80-C603C104K5RAC3121
H1: MCU_4062_100_MODULE_FX6
IC1: APS6404L-3SQR-SN; SOIC127P600X175-8N; Manufacturer_Part_Number APS6404L-3SQR-SN; Mouser Part Number 878-APS6404L-3SQR-SN
J1: 045138008100858+; 045138008100858; Manufacturer_Part_Number 045138008100858+; Mouser Part Number 581-045138008100858+
J3: 1241150-3; 12411503; Manufacturer_Part_Number 1241150-3; Mouser Part Number 571-1241150-3
Q1: IRLML6244TRPBF; SOT95P237X112-3N; Manufacturer_Part_Number IRLML6244TRPBF; Mouser Part Number 942-IRLML6244TRPBF
R1, R3: ERJ-2RKF1002X; ERJ2RKD1004X; Manufacturer_Part_Number ERJ-2RKF1002X; Mouser Part Number 667-ERJ-2RKF1002X
R2: CHP0603QFX-1001ELF; RESC1608X55N; Manufacturer_Part_Number CHP0603QFX-1001ELF; Mouser Part Number 652-CHP0603QFX-1001E
R4: ERJ2RKF1003X; ERJ2RKD1004X; Manufacturer_Part_Number ERJ2RKF1003X
S2: PTS526_SK08_SMTR2_LFS; PTS526SKG15SMTR2LFS; Manufacturer_Part_Number PTS526 SK08 SMTR2 LFS; Mouser Part Number 611-PTS526SK08SMTR2L
U1: STM32L552VETx; LQFP-100_14x14mm_P0.5mm
U2: SMTM1225.TR; SMTM1225TR; Manufacturer_Part_Number SMTM1225.TR; Mouser Part Number 614-SMTM1225.TR
Y1: 405C35D10M00000; Manufacturer_Part_Number 405C35D10M00000; Mouser Part Number 774-405C35D10M00000
Y2: FX135A-327; FX135A327; Manufacturer_Part_Number FX135A-327
Z1: PTZTFTE253.0B; PTZTFTE2530B; Manufacturer_Part_Number PTZTFTE253.0B; Mouser Part Number 755-PTZTFTE253.0B

Connections:
/A3_PIN: H1.3, U1.7 (PC13)
/A4_PIN: H1.4, U1.5 (PE6)
/A5_PIN: H1.5, U1.4 (PE5)
/A6_PIN: H1.6, U1.3 (PE4)
/A7_PIN: H1.7, U1.2 (PE3)
/A8_PIN: H1.8, U1.1 (PE2)
/A9_PIN: H1.9, U1.98 (PE1)
/A10_PIN: H1.10, U1.97 (PE0)
/A11_PIN: H1.11, U1.96 (PB9)
/A12_PIN: H1.12, U1.95 (PB8)
/A13_PIN: H1.13, U1.93 (PB7)
/A14_PIN: H1.14, U1.92 (PB6)
/A15_PIN: H1.15, U1.91 (PB5)
/A16_PIN: H1.16, U1.90 (PB4)
/A17_PIN: H1.17, U1.89 (PB3)
/A27_PIN: H1.27, U1.88 (PD7)
/A28_PIN: H1.28, U1.87 (PD6)
/A29_PIN: H1.29, U1.86 (PD5)
/A30_PIN: H1.30, U1.85 (PD4)
/A31_PIN: H1.31, U1.84 (PD3)
/A32_PIN: H1.32, U1.82 (PD1)
/A33_PIN: H1.33, U1.81 (PD0)
/A34_PIN: H1.34, U1.76 (PA14)
/A35_PIN: H1.35, U1.72 (PA13)
/A36_PIN: H1.36, U1.71 (PA12)
/A37_PIN: H1.37, U1.70 (PA11)
/A38_PIN: H1.38, J3.2, U1.69 (PA10)
/A39_PIN: H1.39, J3.3, U1.68 (PA9)
/A40_PIN: H1.40, U1.67 (PA8)
/A41_PIN: H1.41, U1.64 (PC7)
/A42_PIN: H1.42, U1.63 (PC6)
/B52_PIN: H1.52, U1.62 (PD15)
/B53_PIN: H1.53, U1.61 (PD14)
/B54_PIN: H1.54, U1.60 (PD13)
/B55_PIN: H1.55, U1.59 (PD12)
/B56_PIN: H1.56, U1.58 (PD11)
/B57_PIN: H1.57, U1.57 (PD10)
/B58_PIN: H1.58, U1.56 (PD9)
/B59_PIN: H1.59, U1.55 (PD8)
/B60_PIN: H1.60, U1.54 (PB15)
/B61_PIN: H1.61, U1.53 (PB14)
/B62_PIN: H1.62, U1.52 (PB13)
/B63_PIN: H1.63, U1.51 (PB12)
/B64_PIN: H1.64, U1.48 (PB11)
/B65_PIN: H1.65, U1.47 (PB10)
/B66_PIN: H1.66, U1.40 (PE9)
/B67_PIN: H1.67, U1.39 (PE8)
/B68_PIN: H1.68, U1.38 (PE7)
/B77_PIN: H1.77, U1.37 (PB2)
/B78_PIN: H1.78, U1.36 (PB1)
/B79_PIN: H1.79, U1.35 (PB0)
/B80_PIN: H1.80, U1.34 (PC5)
/B81_PIN: H1.81, U1.33 (PC4)
/B82_PIN: H1.82, U1.32 (PA7)
/B83_PIN: H1.83, U1.31 (PA6)
/B84_PIN: H1.84, U1.30 (PA5)
/B85_PIN: H1.85, U1.29 (PA4)
/B86_PIN: H1.86, U1.26 (PA3)
/B87_PIN: H1.87, U1.25 (PA2)
/B88_PIN: H1.88, U1.24 (PA1)
/B89_PIN: H1.89, U1.23 (PA0)
/B90_PIN: H1.90, U1.18 (PC3)
/B91_PIN: H1.91, U1.17 (PC2)
/B92_PIN: H1.92, U1.16 (PC1)
/B93_PIN: H1.93, U1.15 (PC0)
/MCU_BOOT0: C11.2, R2.1, R3.2, S2.1 (COM_1), U1.94 (PH3), Z1.1
/MCU_NRESET: Q1.3 (D), R1.1, U1.14 (NRST)
/PROG_PIN: H1.94, R2.2
/QSPI_CLK: IC1.6 (SCLK), U1.41 (PE10)
/QSPI_CS: IC1.1 (~CE), U1.42 (PE11)
/QSPI_IO0: IC1.5 (SI/SIO[0]), U1.43 (PE12)
/QSPI_IO1: IC1.2 (SO/SIO[1]), U1.44 (PE13)
/QSPI_IO2: IC1.3 (SIO[2]), U1.45 (PE14)
/QSPI_IO3: IC1.7 (SIO[3]), U1.46 (PE15)
/RCC_OSC32_IN: C9.2, U1.8 (PC14), Y2.2
/RCC_OSC32_OUT: C8.2, U1.9 (PC15), Y2.1
/RCC_OSC_IN: C7.1, U1.12 (PH0), Y1.3 (CRYSTAL_2)
/RCC_OSC_OUT: C6.2, U1.13 (PH1), Y1.1 (CRYSTAL_1)
/SD_CD1: J1.CD1, U1.77 (PA15)
/SD_CLK: J1.5 (CLK), U1.80 (PC12)
/SD_CMD: J1.3 (CMD), U1.83 (PD2)
/SD_COM: J1.9 (COM)
/SD_DAT0: J1.7 (DAT0), U1.65 (PC8)
/SD_DAT1: J1.8 (DAT1), U1.66 (PC9)
/SD_DAT2: J1.1 (DAT2), U1.78 (PC10)
/SD_DAT3: J1.2 (CD/DAT3), U1.79 (PC11)
/VBAT: U1.6 (VBAT), U2.1 (+_1), U2.2 (+_2)
/VCC2: H1.26
/VCC3: C1.1, C2.1, C3.1, C4.1, C5.1, C10.1, C12.1, H1.1, H1.2, IC1.8 (VDD), J1.4 (VDD), R1.2, S2.2 (COM_2), U1.11 (VDD), U1.21 (VREF+), U1.22 (VDDA), U1.28 (VDD), U1.50 (VDD), U1.73 (VDDUSB), U1.75 (VDD), U1.100 (VDD)
GND: C1.2, C2.2, C3.2, C4.2, C5.2, C6.1, C7.2, C8.1, C9.1, C10.2, C12.2, H1.18, H1.19, H1.20, H1.21, H1.22, H1.23, H1.24, H1.25, H1.43, H1.44, H1.45, H1.46, H1.47, H1.48, H1.49, H1.50, H1.51, H1.69, H1.70, H1.71, H1.72, H1.73, H1.74, H1.75, H1.76, H1.95, H1.96, H1.97, H1.98, H1.99, H1.100, IC1.4 (VSS), J1.6 (VSS), J1.10, J1.11, J1.12, J1.13, J3.1, Q1.2 (S), R3.1, R4.1, S2.3 (NO_1), S2.4 (NO_2), U1.10 (VSS), U1.19 (VSSA), U1.20 (VREF-), U1.27 (VSS), U1.49 (VSS), U1.74 (VSS), U1.99 (VSS), U2.3 (NEGATIVE_CONTACT_PAD), Y1.2 (GND_1), Y1.4 (GND_2), Z1.2
unnamed: C11.1, Q1.1 (G), R4.2

Notes on the sheet:
EDGE_CONNECTOR
USART1_CONNECTOR
BOOTLOADER
CLOCK
STM32 LQFP FREE
MCU
BATTERY
MICROSD
PSRAM

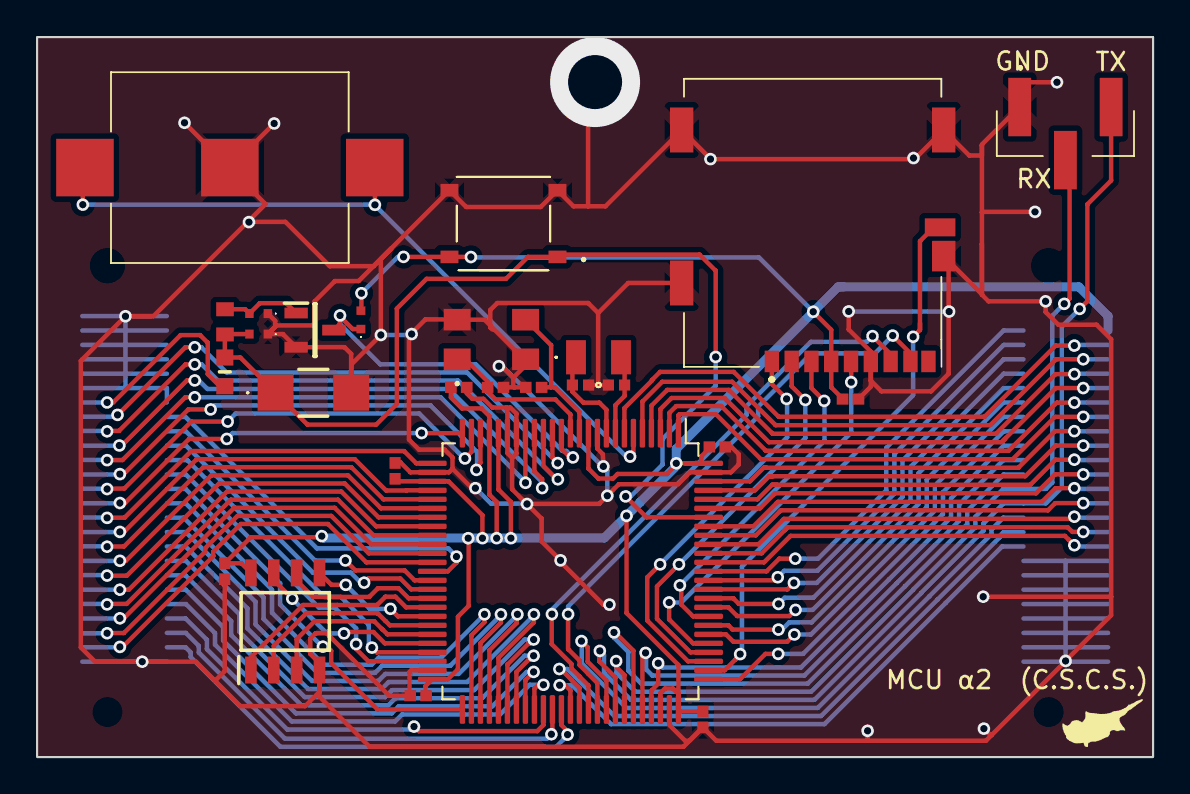
[picture p3: board MCU_α2.kicad_pcb from above]

Board: 2 copper layers, 62.0 x 40.0 mm, 27 parts (1 on the bottom side), 89 nets.
