Cyprus-Subsea/Smart-Cable-2-Hardware/modules/DIRECT/I2C/α1/DIRECT_I2C_α1.kicad_pcb

## KiCad design modules/DIRECT/I2C/α1/DIRECT_I2C_α1.kicad_pcb (2023-06-07)

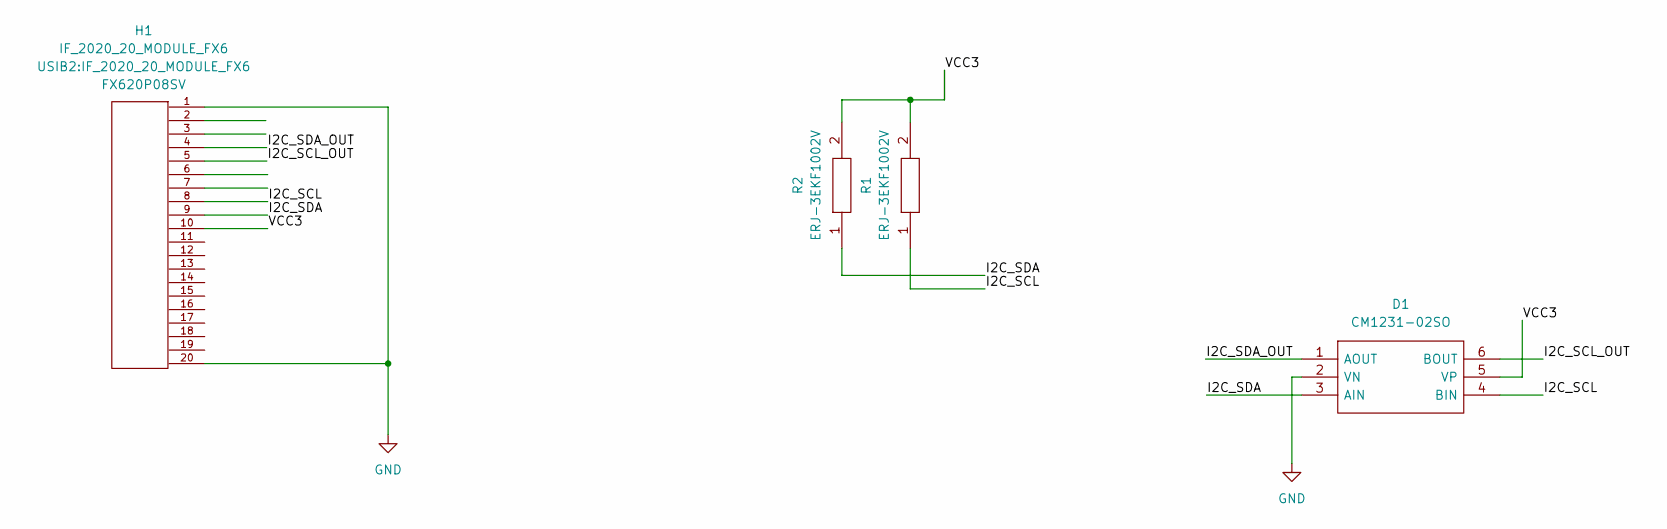
[picture p4: schematic DIRECT_I2C_α1.kicad_sch]

Parts:
D1: CM1231-02SO; SOT95P280X145-6N; Manufacturer_Part_Number CM1231-02SO; Mouser Part Number 748-CM1231-02SO
H1: IF_2020_20_MODULE_FX6
R1, R2: ERJ-3EKF1002V; ERJ3EK_(0603); Manufacturer_Part_Number ERJ-3EKF1002V; Mouser Part Number 667-ERJ-3EKF1002V

Connections:
/I2C_SCL: D1.4 (BIN), H1.8, R1.1
/I2C_SCL_OUT: D1.6 (BOUT), H1.5
/I2C_SDA: D1.3 (AIN), H1.9, R2.1
/I2C_SDA_OUT: D1.1 (AOUT), H1.4
/VCC3: D1.5 (VP), H1.10, R1.2, R2.2
GND: D1.2 (VN), H1.1, H1.20

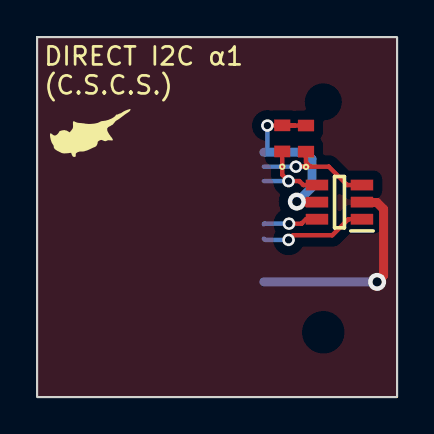
[picture p5: board DIRECT_I2C_α1.kicad_pcb from above]

Board: 2 copper layers, 20.0 x 20.0 mm, 4 parts (1 on the bottom side), 6 nets.
