Cyprus-Subsea/Smart-Cable-2-Hardware/modules/IMU/α1/IMU_α1.kicad_pcb

## KiCad design modules/IMU/α1/IMU_α1.kicad_pcb (2023-06-07)

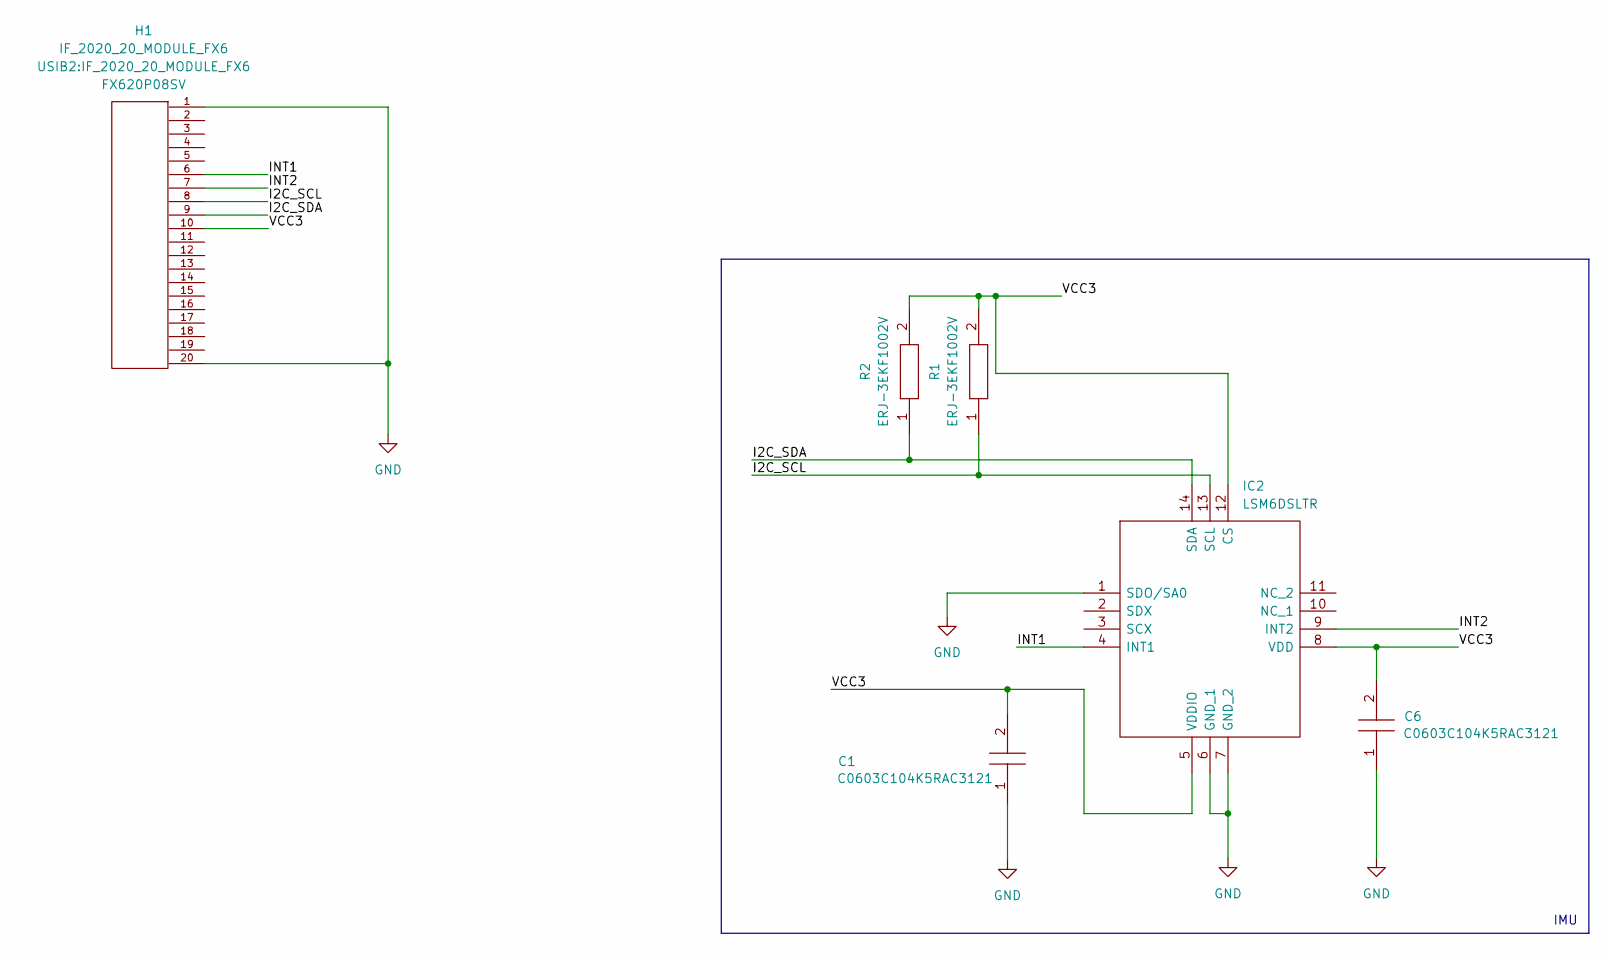
[picture p6: schematic IMU_α1.kicad_sch]

Parts:
C1, C6: C0603C104K5RAC3121; CAPC1608X95N; Manufacturer_Part_Number C0603C104K5RAC3121; Mouser Part Number 80-C603C104K5RAC3121
H1: IF_2020_20_MODULE_FX6
IC2: LSM6DSLTR; Manufacturer_Part_Number LSM6DSLTR; Mouser Part Number 511-LSM6DSLTR
R1, R2: ERJ-3EKF1002V; ERJ3EK_(0603); Manufacturer_Part_Number ERJ-3EKF1002V; Mouser Part Number 667-ERJ-3EKF1002V

Connections:
/I2C_SCL: H1.8, IC2.13 (SCL), R1.1
/I2C_SDA: H1.9, IC2.14 (SDA), R2.1
/INT1: H1.6, IC2.4 (INT1)
/INT2: H1.7, IC2.9 (INT2)
/VCC3: C1.2, C6.2, H1.10, IC2.5 (VDDIO), IC2.8 (VDD), IC2.12 (CS), R1.2, R2.2
GND: C1.1, C6.1, H1.1, H1.20, IC2.1 (SDO/SA0), IC2.6 (GND_1), IC2.7 (GND_2)

Notes on the sheet:
IMU

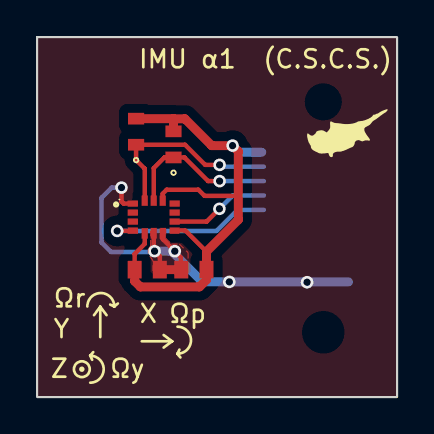
[picture p7: board IMU_α1.kicad_pcb from above]

Board: 2 copper layers, 20.0 x 20.0 mm, 6 parts (1 on the bottom side), 6 nets.
