Cyprus-Subsea/Smart-Cable-2-Hardware/modules/RS232-2/α1/RS232-2_α1.kicad_pcb

## KiCad design modules/RS232-2/α1/RS232-2_α1.kicad_pcb (2023-06-07)

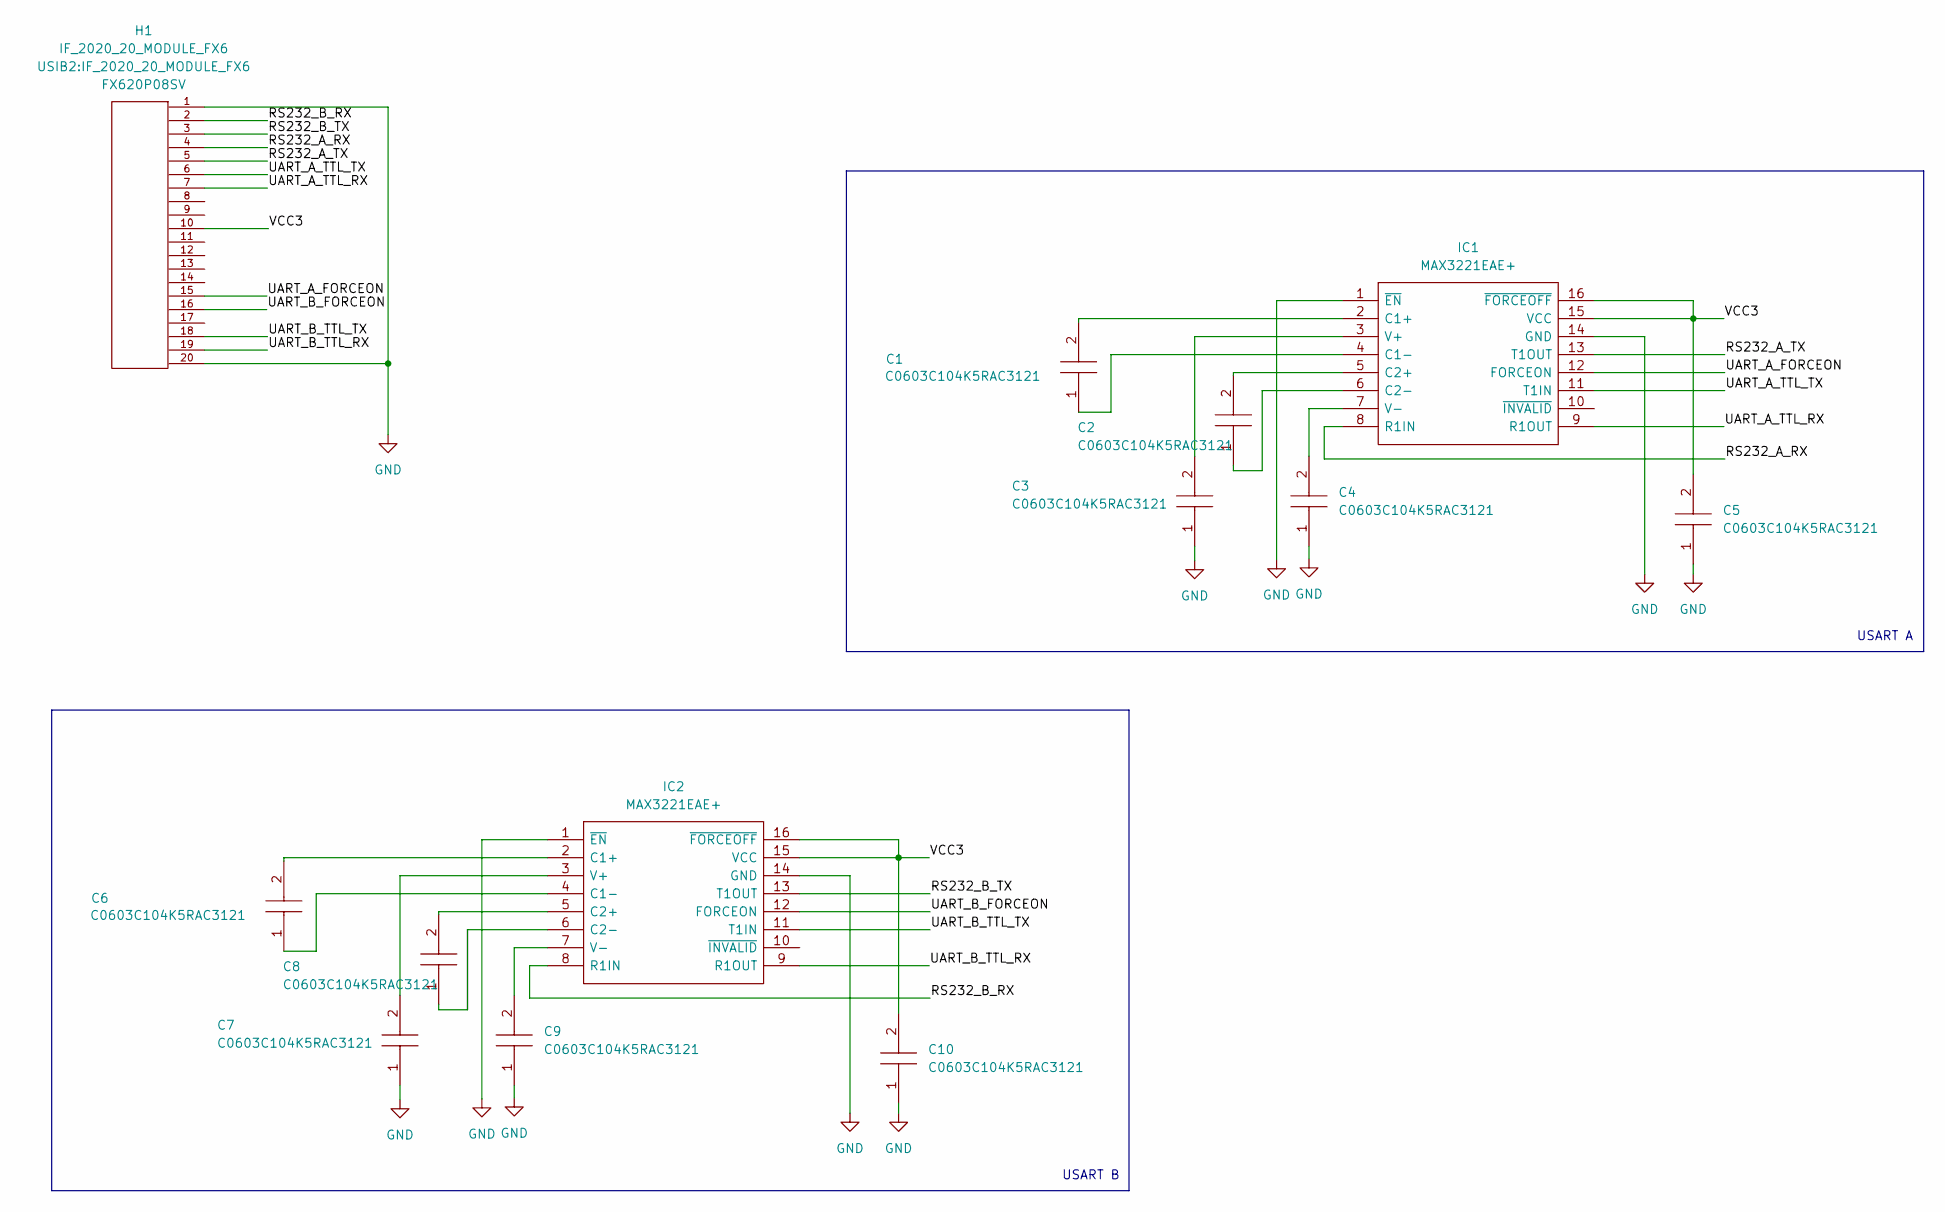
[picture p8: schematic RS232-2_α1.kicad_sch]

Parts:
C1, C2, C3, C4, C5, C6, C7, C8, C9, C10: C0603C104K5RAC3121; CAPC1608X95N; Manufacturer_Part_Number C0603C104K5RAC3121; Mouser Part Number 80-C603C104K5RAC3121
H1: IF_2020_20_MODULE_FX6
IC1, IC2: MAX3221EAE+; SOP65P778X199-16N; Manufacturer_Part_Number MAX3221EAE+; Mouser Part Number 700-MAX3221EAE

Connections:
/RS232_A_RX: H1.4, IC1.8 (R1IN)
/RS232_A_TX: H1.5, IC1.13 (T1OUT)
/RS232_B_RX: H1.2, IC2.8 (R1IN)
/RS232_B_TX: H1.3, IC2.13 (T1OUT)
/UART_A_FORCEON: H1.15, IC1.12 (FORCEON)
/UART_A_TTL_RX: H1.7, IC1.9 (R1OUT)
/UART_A_TTL_TX: H1.6, IC1.11 (T1IN)
/UART_B_FORCEON: H1.16, IC2.12 (FORCEON)
/UART_B_TTL_RX: H1.19, IC2.9 (R1OUT)
/UART_B_TTL_TX: H1.18, IC2.11 (T1IN)
/VCC3: C5.2, C10.2, H1.10, IC1.15 (VCC), IC1.16 (~FORCEOFF), IC2.15 (VCC), IC2.16 (~FORCEOFF)
GND: C3.1, C4.1, C5.1, C7.1, C9.1, C10.1, H1.1, H1.20, IC1.1 (~EN), IC1.14 (GND), IC2.1 (~EN), IC2.14 (GND)
unnamed: C1.2, IC1.2 (C1+)
unnamed: C1.1, IC1.4 (C1-)
unnamed: C2.2, IC1.5 (C2+)
unnamed: C2.1, IC1.6 (C2-)
unnamed: C3.2, IC1.3 (V+)
unnamed: C4.2, IC1.7 (V-)
unnamed: C6.2, IC2.2 (C1+)
unnamed: C6.1, IC2.4 (C1-)
unnamed: C8.2, IC2.5 (C2+)
unnamed: C8.1, IC2.6 (C2-)
unnamed: C7.2, IC2.3 (V+)
unnamed: C9.2, IC2.7 (V-)

Notes on the sheet:
USART A
USART B

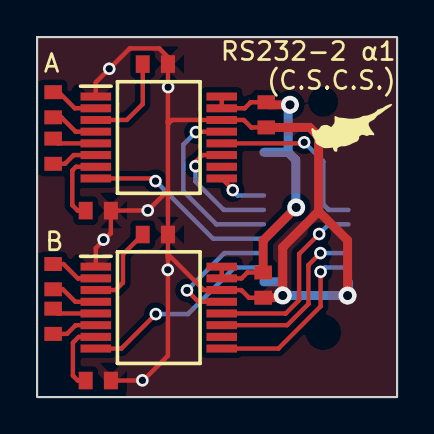
[picture p9: board RS232-2_α1.kicad_pcb from above]

Board: 2 copper layers, 20.0 x 20.0 mm, 13 parts (1 on the bottom side), 24 nets.
