Cyprus-Subsea/Smart-Cable-2-Hardware/motherboard/α1/MB_α1.kicad_pcb

## KiCad design motherboard/α1/MB_α1.kicad_pcb (2023-06-06)

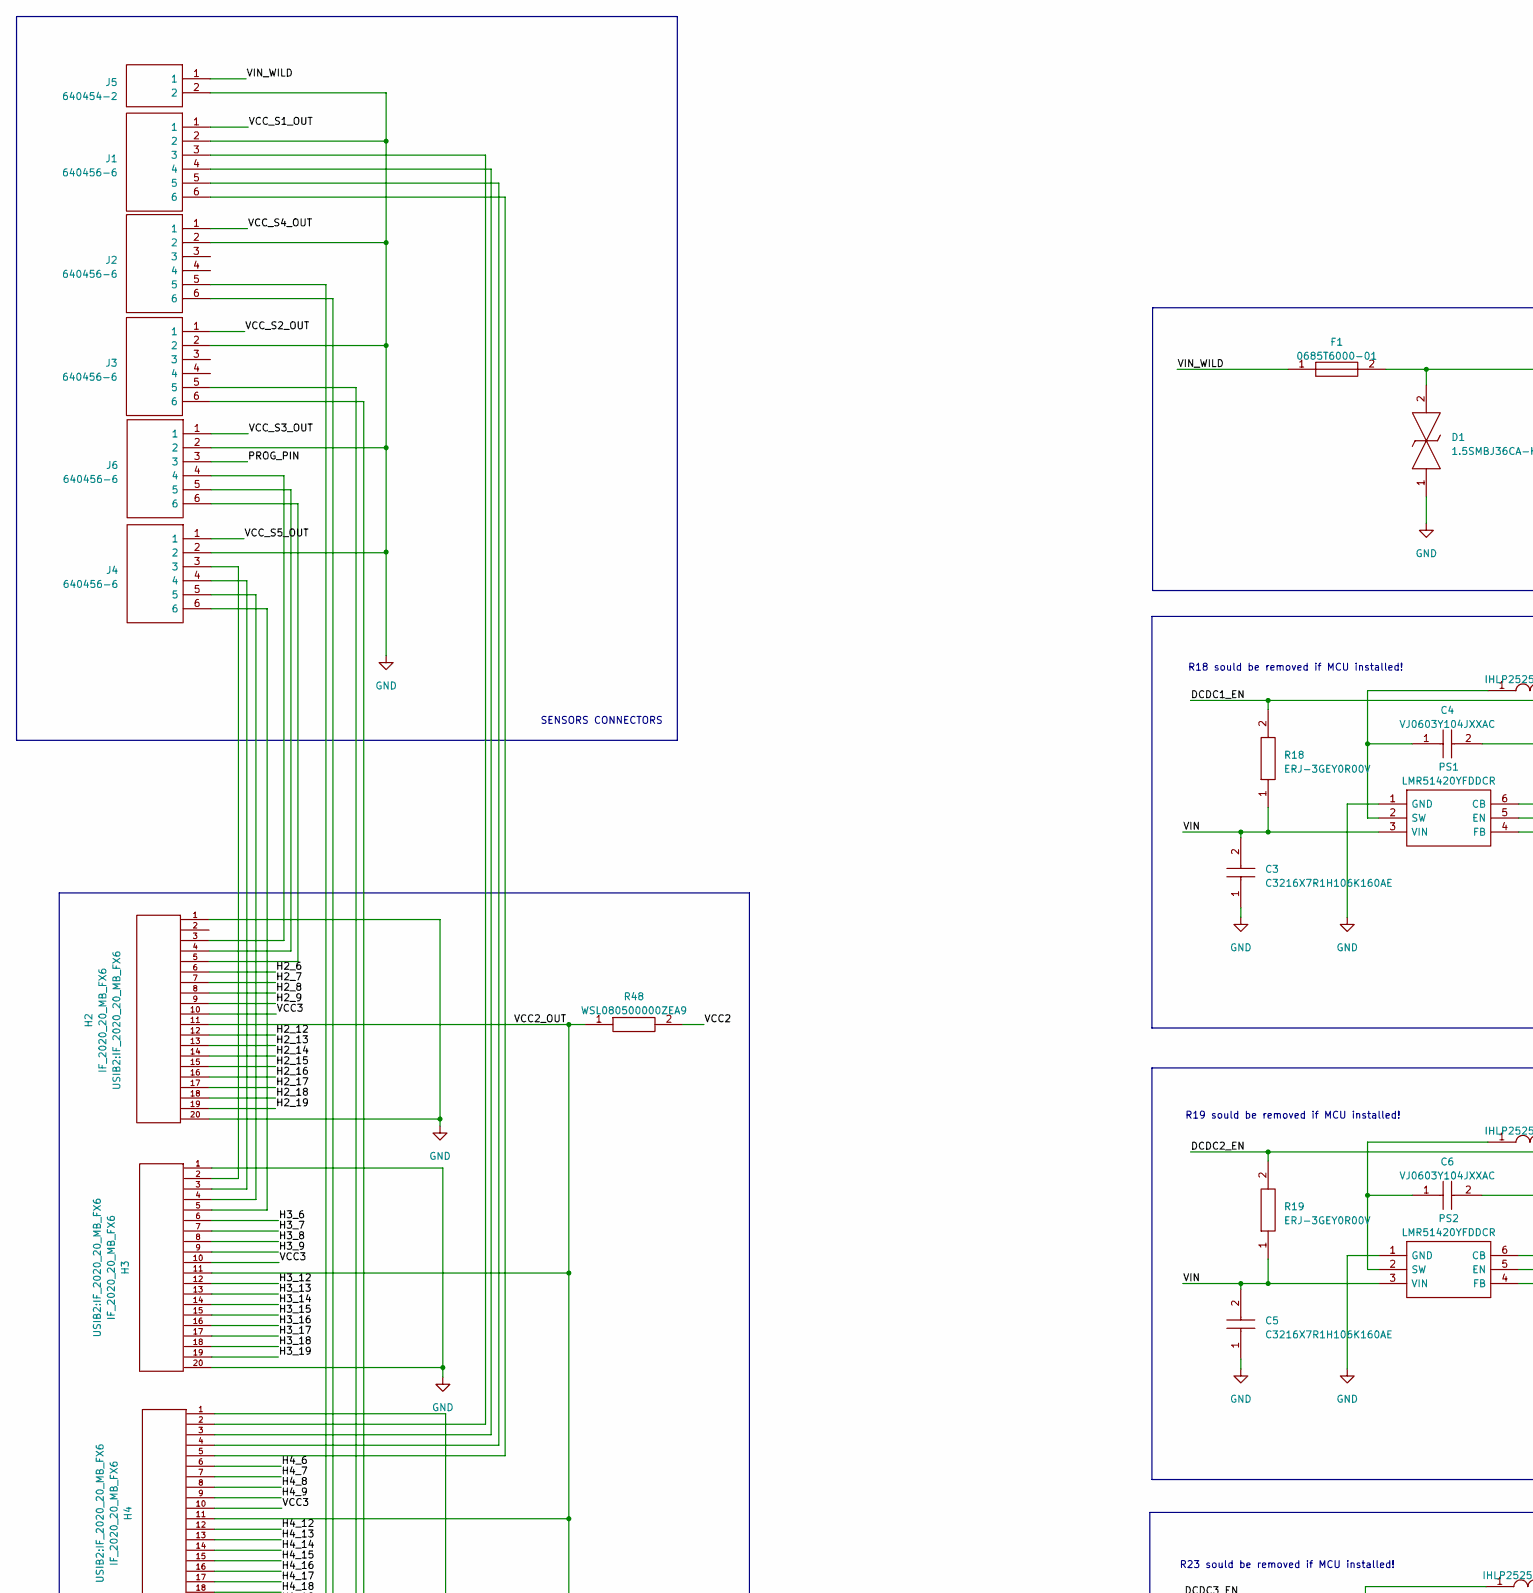
[picture p10: schematic MB_α1.kicad_sch, part in row 1, column 1]

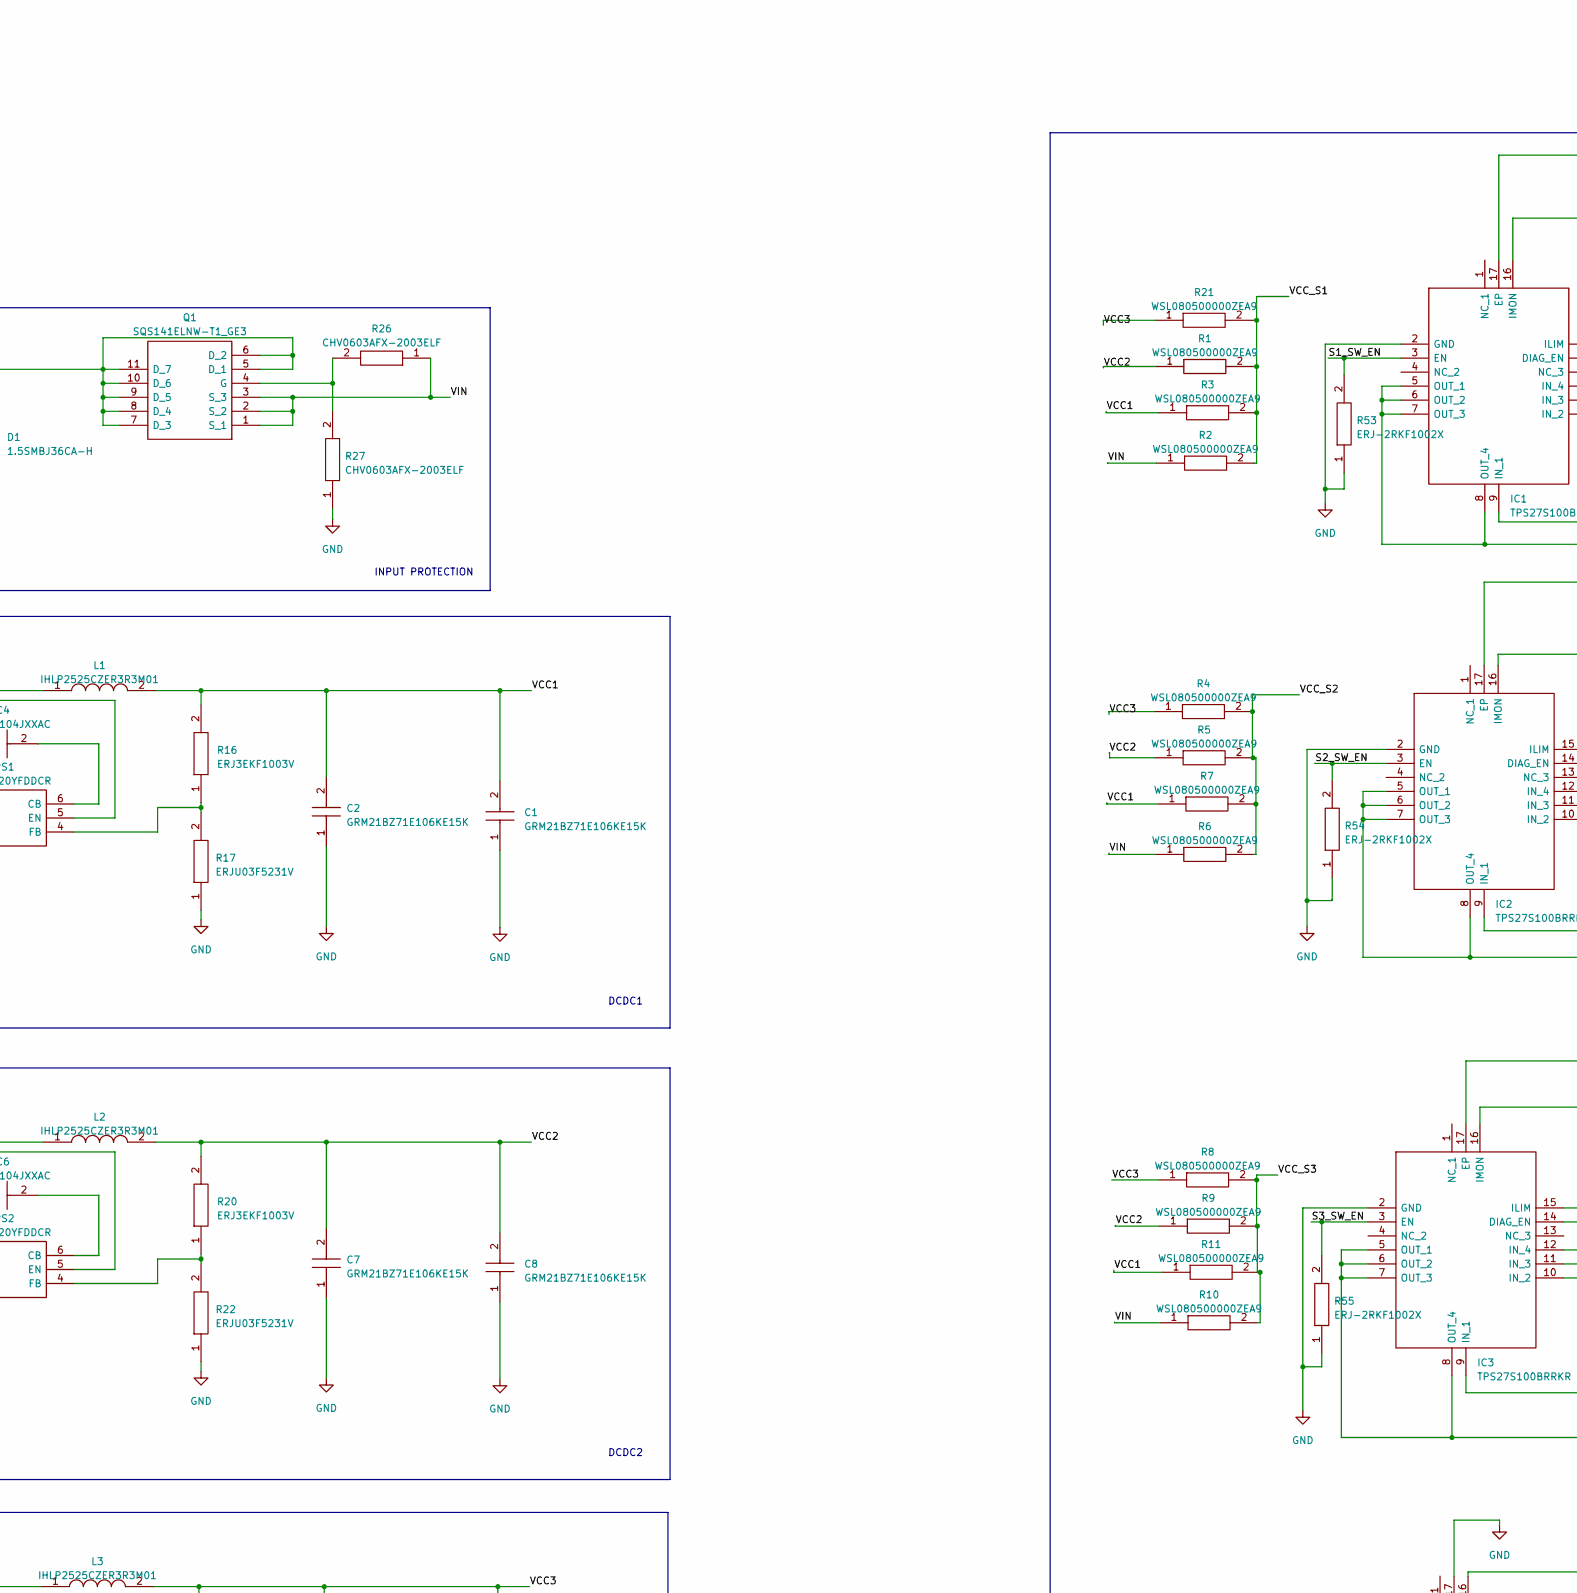
[picture p11: schematic MB_α1.kicad_sch, part in row 1, column 2]

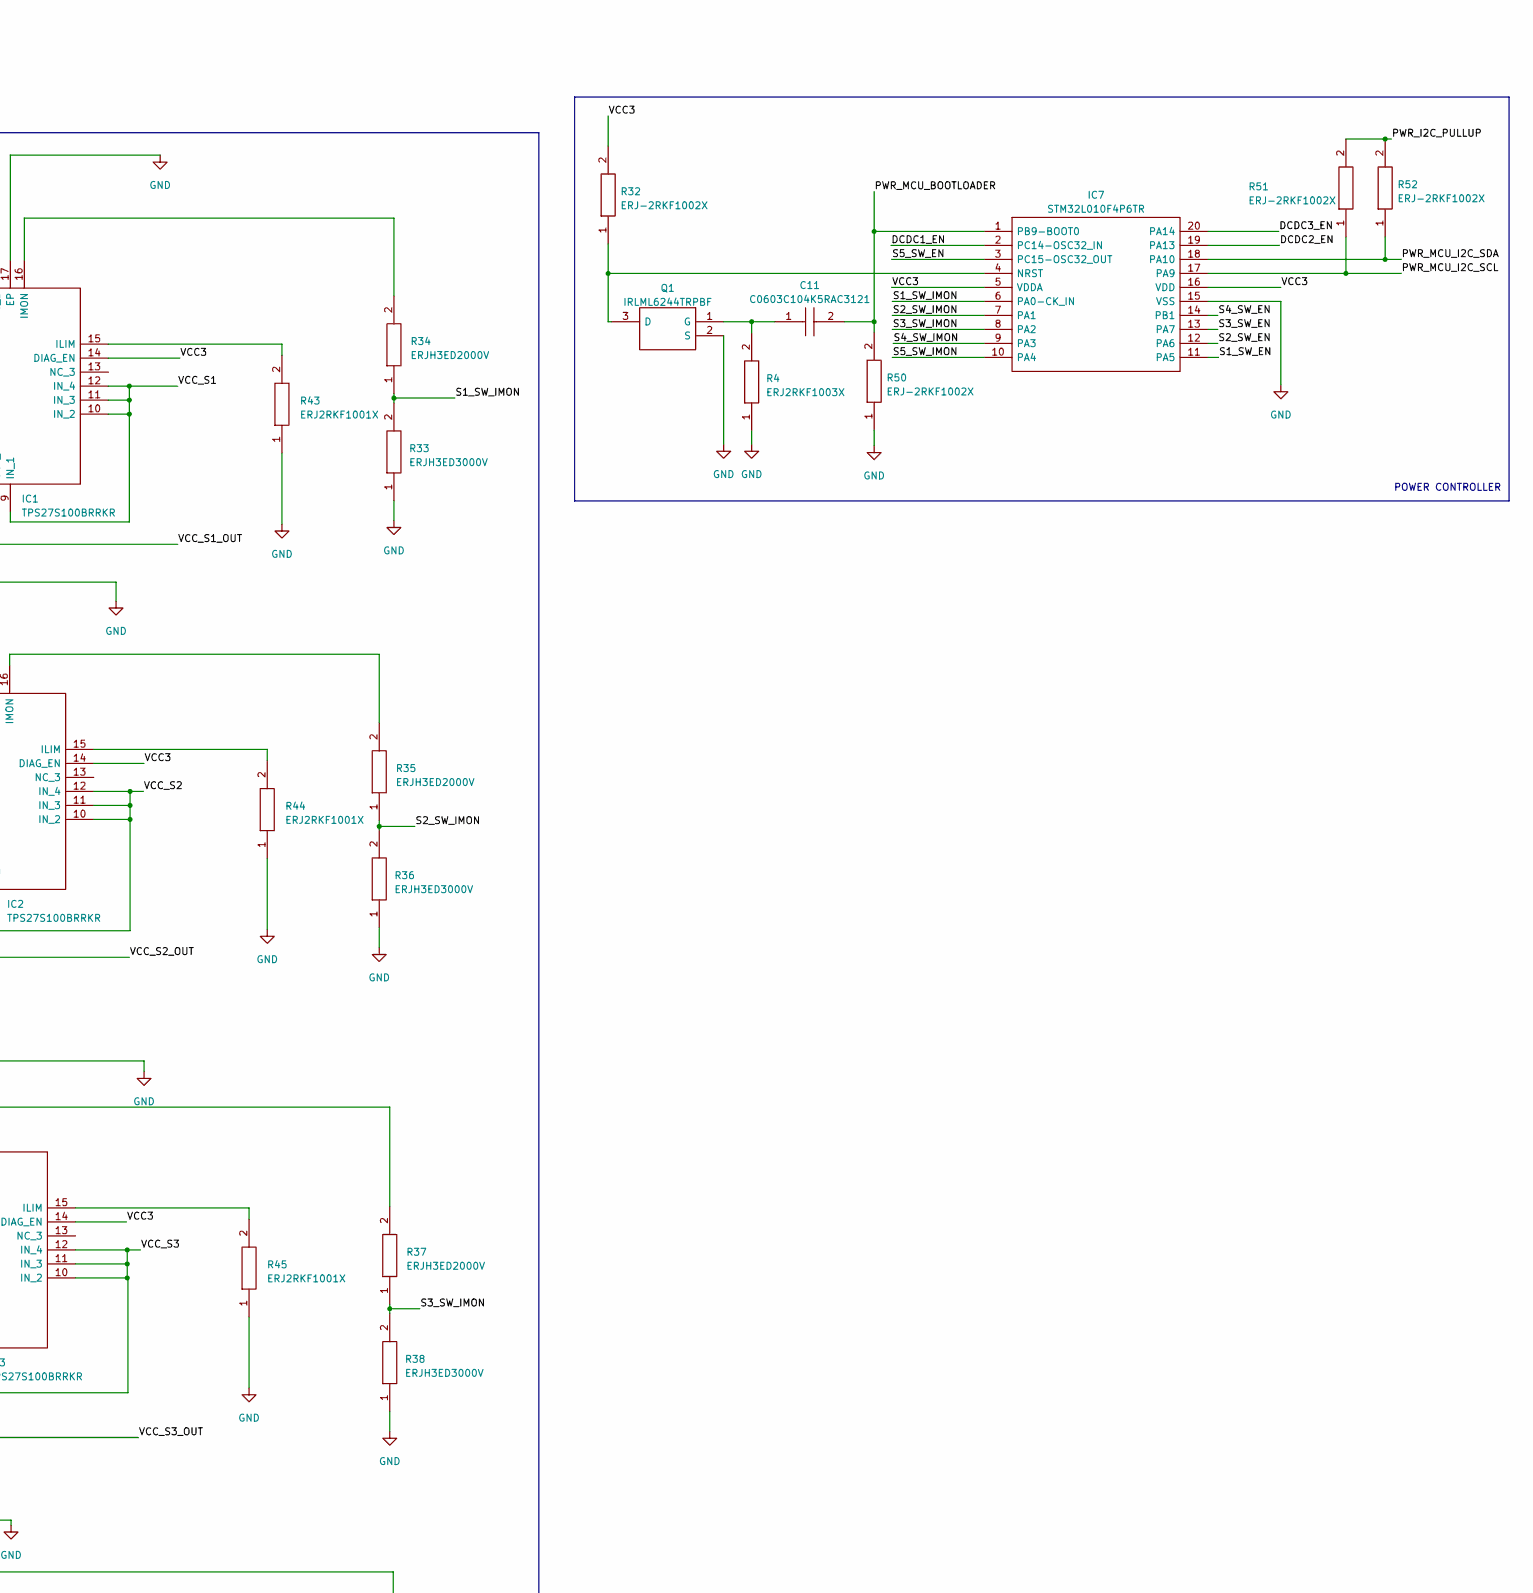
[picture p12: schematic MB_α1.kicad_sch, part in row 1, column 3]

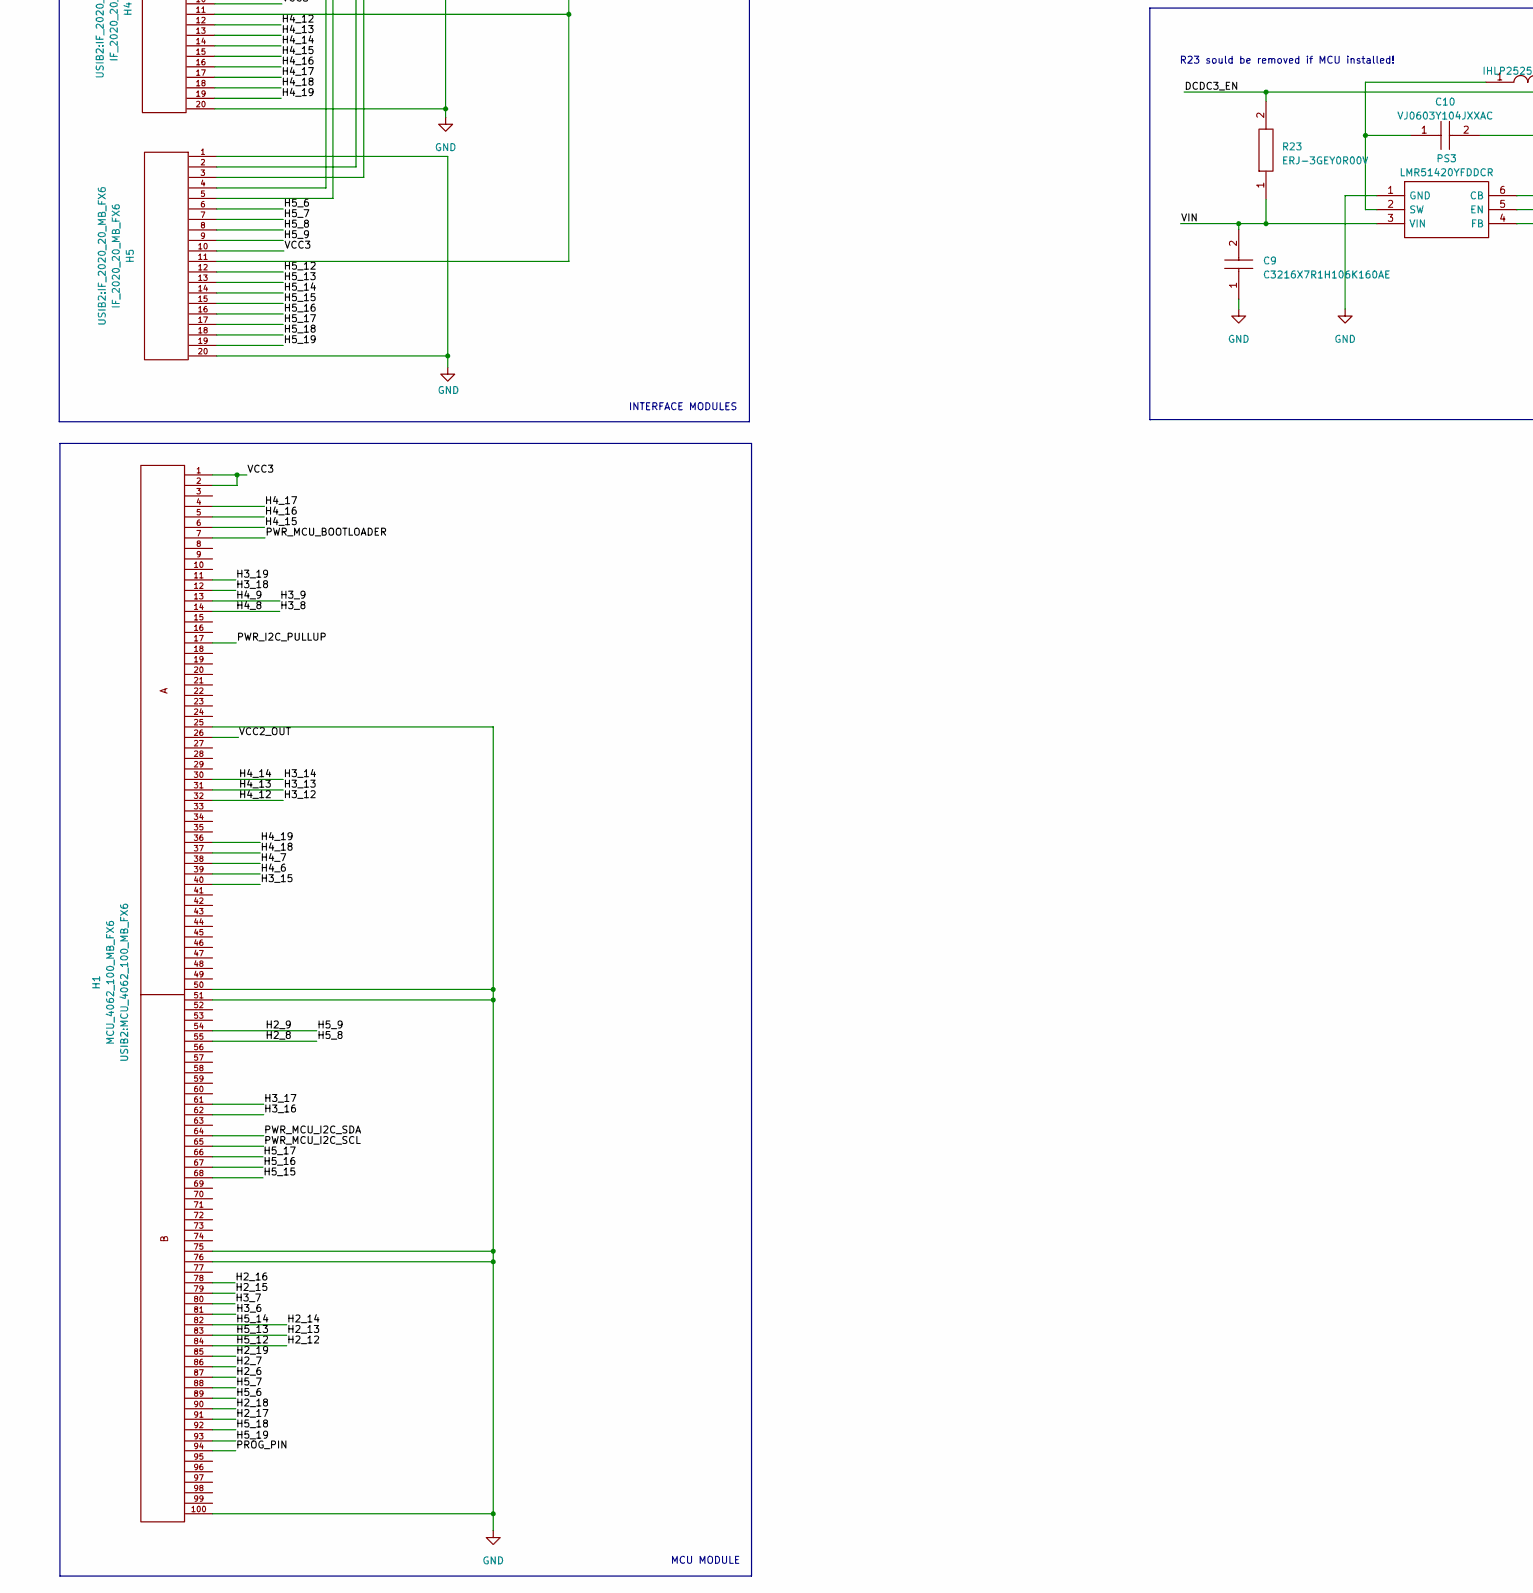
[picture p13: schematic MB_α1.kicad_sch, part in row 2, column 1]

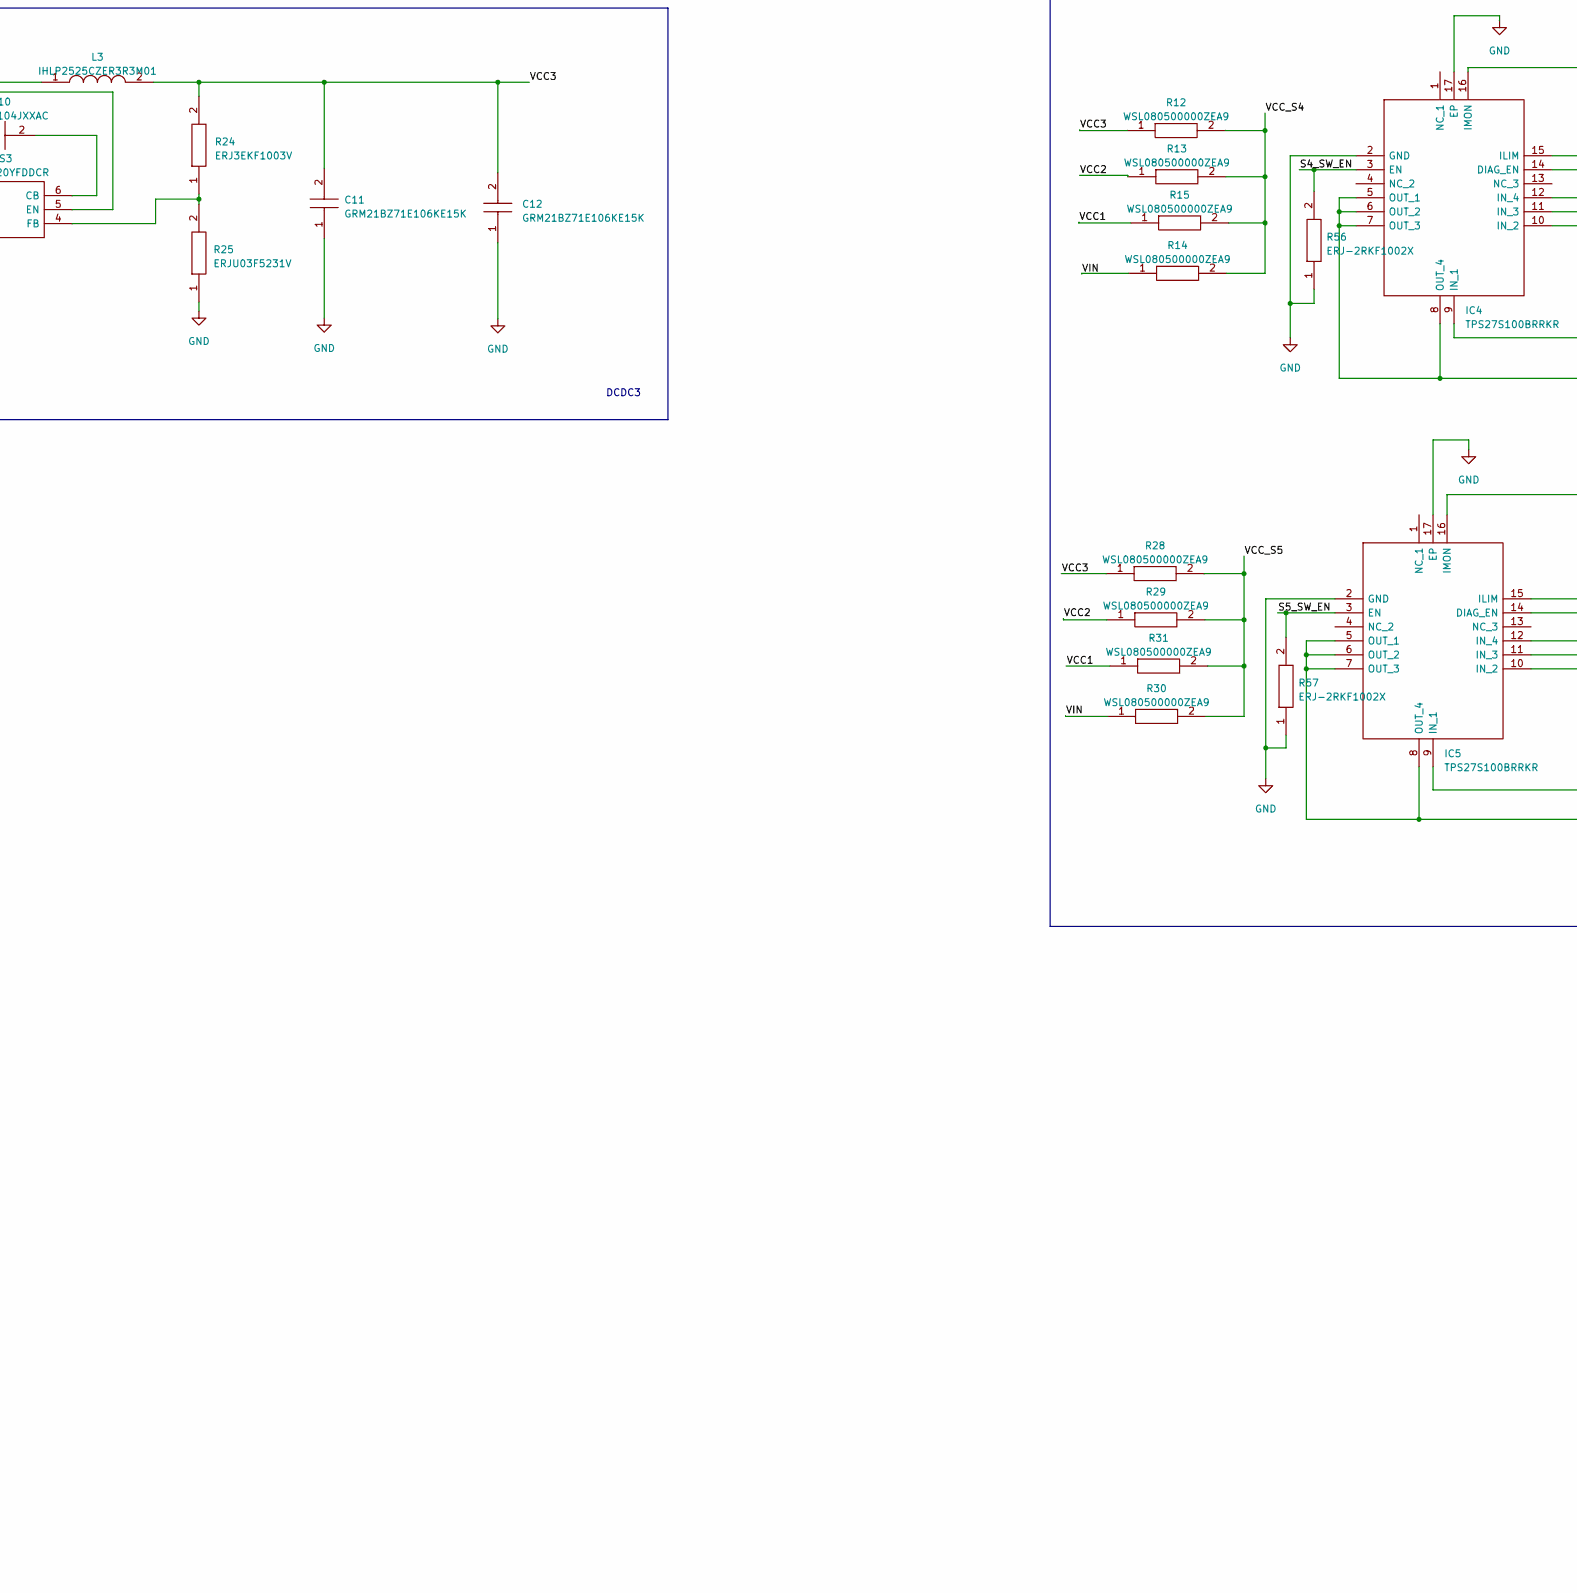
[picture p14: schematic MB_α1.kicad_sch, part in row 2, column 2]

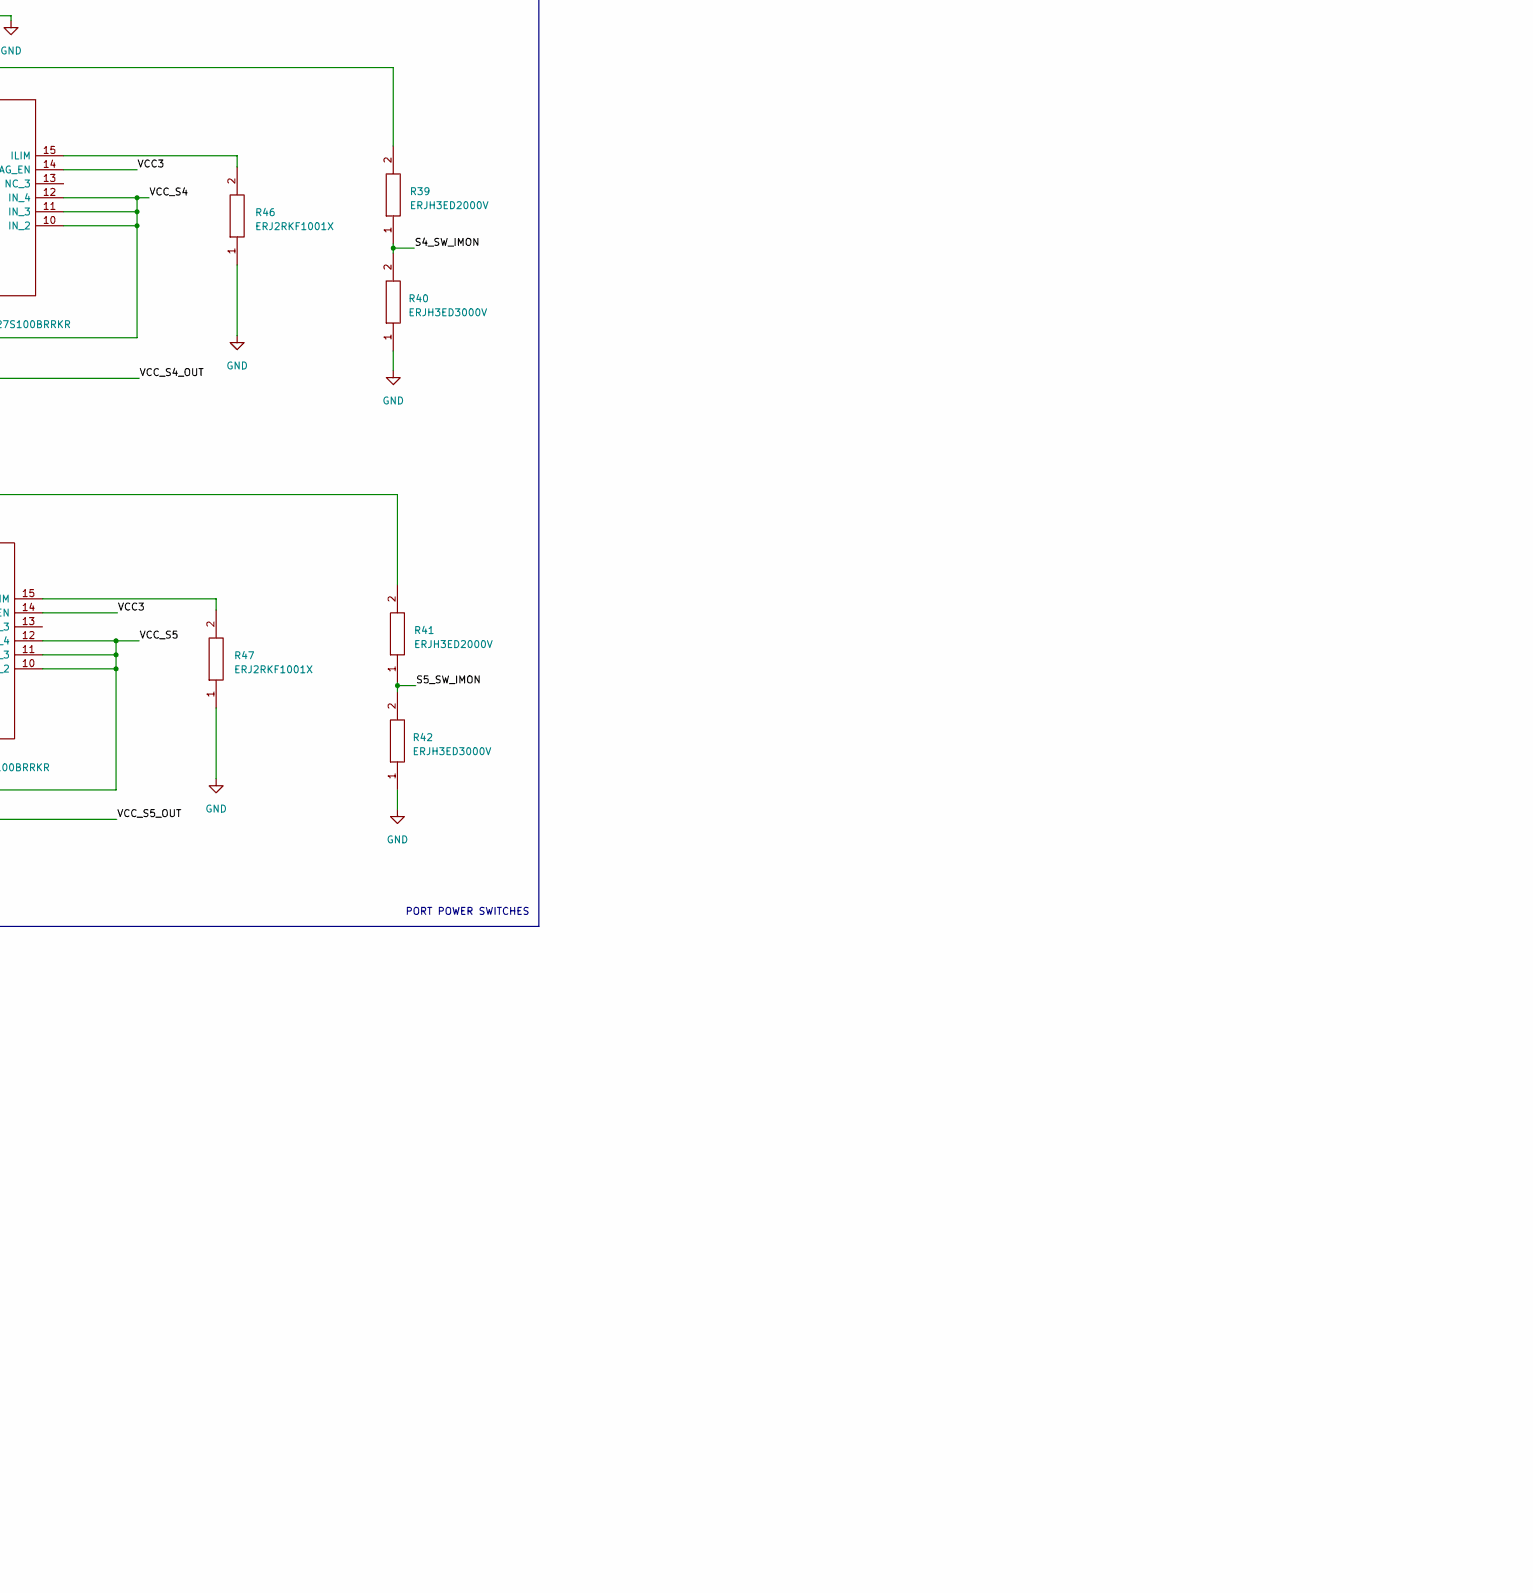
[picture p15: schematic MB_α1.kicad_sch, part in row 2, column 3]

Parts:
C1, C2, C7, C8, C11, C12: GRM21BZ71E106KE15K; CAPC2012X145N; Manufacturer_Part_Number GRM21BZ71E106KE15K; Mouser Part Number 81-GRM21BZ71E106KE5K
C3, C5, C9: C3216X7R1H106K160AE; CAPC3216X180N; Manufacturer_Part_Number C3216X7R1H106K160AE; Mouser Part Number 810-C3216X7R1H106160
C4, C6, C10: VJ0603Y104JXXAC; CAPC1608X97N; Manufacturer_Part_Number VJ0603Y104JXXAC; Mouser Part Number 77-VJ0603Y104JXXAC
D1: 1.5SMBJ36CA-H; DIONM5436X244N; Manufacturer_Part_Number 1.5SMBJ36CA-H; Mouser Part Number 652-1.5SMBJ36CA-H
F1: 0685T6000-01; FUSC3216X83N; Manufacturer_Part_Number 0685T6000-01; Mouser Part Number 530-0685T6000-01
H1: MCU_4062_100_MB_FX6
H2, H3, H4, H5: IF_2020_20_MB_FX6
IC1, IC2, IC3, IC4, IC5: TPS27S100BRRKR; Manufacturer_Part_Number TPS27S100BRRKR; Mouser Part Number 595-TPS27S100BRRKR
IC7: STM32L010F4P6TR; SOP65P640X120-20N; Manufacturer_Part_Number STM32L010F4P6TR; Mouser Part Number 511-STM32L010F4P6TR
J1, J2, J3, J4, J6: 640456-6; SHDR6W66P0X254_1X6_1524X572X1003P; Manufacturer_Part_Number 640456-6; Mouser Part Number 571-6404566
J5: 640454-2; HDRV2W66P0X254_1X2_762X572X1003P; Manufacturer_Part_Number 640454-2; Mouser Part Number 571-640454-2
L1, L2, L3: IHLP2525CZER3R3M01; INDPM6965X300N; Manufacturer_Part_Number IHLP2525CZER3R3M01; Mouser Part Number 70-IHLP2525CZER3R3M0
PS1, PS2, PS3: LMR51420YFDDCR; SOT95P280X110-6N; Manufacturer_Part_Number LMR51420YFDDCR; Mouser Part Number 595-LMR51420YFDDCR
Q1: IRLML6244TRPBF; SOT95P237X112-3N; Manufacturer_Part_Number IRLML6244TRPBF; Mouser Part Number 942-IRLML6244TRPBF
R1, R2, R3, R4, R5, R6, R7, R8, R9, R10, R11, R12, R13, R14, R15, R21, R28, R29, R30, R31, R48: WSL080500000ZEA9; RESC2013X84N; Manufacturer_Part_Number WSL080500000ZEA9; Mouser Part Number 71-WSL080500000ZEA9
R16, R20, R24: ERJ3EKF1003V; ERJ3EKF1000V; Manufacturer_Part_Number ERJ3EKF1003V
R17, R22, R25: ERJU03F5231V; ERJS03J155V; Manufacturer_Part_Number ERJU03F5231V
R18, R19, R23: ERJ-3GEY0R00V; ERJ3EKF1000V; Manufacturer_Part_Number ERJ-3GEY0R00V; Mouser Part Number 667-ERJ-3GEY0R00V
R26, R27: CHV0603AFX-2003ELF; RESC1608X55N; Manufacturer_Part_Number CHV0603AFX-2003ELF; Mouser Part Number 652-CHV0603AFX2003LF
R32, R50, R51, R52, R53, R54, R55, R56, R57: ERJ-2RKF1002X; ERJ2RKD1004X; Manufacturer_Part_Number ERJ-2RKF1002X; Mouser Part Number 667-ERJ-2RKF1002X
R33, R36, R38, R40, R42: ERJH3ED3000V; ERJH3; Manufacturer_Part_Number ERJH3ED3000V
R34, R35, R37, R39, R41: ERJH3ED2000V; ERJH3; Manufacturer_Part_Number ERJH3ED2000V
R43, R44, R45, R46, R47: ERJ2RKF1001X; ERJ2RKD1004X; Manufacturer_Part_Number ERJ2RKF1001X

Connections:
/DCDC1_EN: IC7.2 (PC14-OSC32_IN), PS1.5 (EN), R18.2
/DCDC2_EN: IC7.19 (PA13), PS2.5 (EN), R19.2
/DCDC3_EN: IC7.20 (PA14), PS3.5 (EN), R23.2
/H2_6: H1.87, H2.6
/H2_7: H1.86, H2.7
/H2_8: H1.55, H2.8, H5.8
/H2_9: H1.54, H2.9, H5.9
/H2_12: H1.84, H2.12, H5.12
/H2_13: H1.83, H2.13, H5.13
/H2_14: H1.82, H2.14, H5.14
/H2_15: H1.79, H2.15
/H2_16: H1.78, H2.16
/H2_17: H1.91, H2.17
/H2_18: H1.90, H2.18
/H2_19: H1.85, H2.19
/H3_6: H1.81, H3.6
/H3_7: H1.80, H3.7
/H3_8: H1.14, H3.8, H4.8
/H3_9: H1.13, H3.9, H4.9
/H3_12: H1.32, H3.12, H4.12
/H3_13: H1.31, H3.13, H4.13
/H3_14: H1.30, H3.14, H4.14
/H3_15: H1.40, H3.15
/H3_16: H1.62, H3.16
/H3_17: H1.61, H3.17
/H3_18: H1.12, H3.18
/H3_19: H1.11, H3.19
/H4_6: H1.39, H4.6
/H4_7: H1.38, H4.7
/H4_15: H1.6, H4.15
/H4_16: H1.5, H4.16
/H4_17: H1.4, H4.17
/H4_18: H1.37, H4.18
/H4_19: H1.36, H4.19
/H5_6: H1.89, H5.6
/H5_7: H1.88, H5.7
/H5_15: H1.68, H5.15
/H5_16: H1.67, H5.16
/H5_17: H1.66, H5.17
/H5_18: H1.92, H5.18
/H5_19: H1.93, H5.19
/PROG_PIN: H1.94, J6.3
/PWR_I2C_PULLUP: H1.17, R51.2, R52.2
/PWR_MCU_I2C_SCL: H1.65, IC7.17 (PA9), R51.1
/PWR_MCU_I2C_SDA: H1.64, IC7.18 (PA10), R52.1
/S1_SW_EN: IC1.3 (EN), IC7.11 (PA5), R53.2
/S1_SW_IMON: IC7.6 (PA0-CK_IN), R33.2, R34.1
/S2_SW_EN: IC2.3 (EN), IC7.12 (PA6), R54.2
/S2_SW_IMON: IC7.7 (PA1), R35.1, R36.2
/S3_SW_EN: IC3.3 (EN), IC7.13 (PA7), R55.2
/S3_SW_IMON: IC7.8 (PA2), R37.1, R38.2
/S4_SW_EN: IC4.3 (EN), IC7.14 (PB1), R56.2
/S4_SW_IMON: IC7.9 (PA3), R39.1, R40.2
/S5_SW_EN: IC5.3 (EN), IC7.3 (PC15-OSC32_OUT), R57.2
/S5_SW_IMON: IC7.10 (PA4), R41.1, R42.2
/VCC1: C1.2, C2.2, L1.2, R3.1, R7.1, R11.1, R15.1, R16.2, R31.1
/VCC2: C7.2, C8.2, L2.2, R1.1, R5.1, R9.1, R13.1, R20.2, R29.1, R48.2
/VCC2_OUT: H1.26, H2.11, H3.11, H4.11, H5.11, R48.1
/VCC_S1: IC1.9 (IN_1), IC1.10 (IN_2), IC1.11 (IN_3), IC1.12 (IN_4), R1.2, R2.2, R3.2, R21.2
/VCC_S1_OUT: IC1.5 (OUT_1), IC1.6 (OUT_2), IC1.7 (OUT_3), IC1.8 (OUT_4), J1.1
/VCC_S2_OUT: IC2.5 (OUT_1), IC2.6 (OUT_2), IC2.7 (OUT_3), IC2.8 (OUT_4), J3.1
/VCC_S3: IC3.9 (IN_1), IC3.10 (IN_2), IC3.11 (IN_3), IC3.12 (IN_4), R8.2, R9.2, R10.2, R11.2
/VCC_S3_OUT: IC3.5 (OUT_1), IC3.6 (OUT_2), IC3.7 (OUT_3), IC3.8 (OUT_4), J6.1
/VCC_S4: IC4.9 (IN_1), IC4.10 (IN_2), IC4.11 (IN_3), IC4.12 (IN_4), R12.2, R13.2, R14.2, R15.2
/VCC_S4_OUT: IC4.5 (OUT_1), IC4.6 (OUT_2), IC4.7 (OUT_3), IC4.8 (OUT_4), J2.1
/VCC_S5: IC5.9 (IN_1), IC5.10 (IN_2), IC5.11 (IN_3), IC5.12 (IN_4), R28.2, R29.2, R30.2, R31.2
/VCC_S5_OUT: IC5.5 (OUT_1), IC5.6 (OUT_2), IC5.7 (OUT_3), IC5.8 (OUT_4), J4.1
/VIN_WILD: F1.1, J5.1
unnamed: H2.3, J6.4
unnamed: H2.4, J6.5
unnamed: H2.5, J6.6
unnamed: H3.2, J4.3
unnamed: H3.3, J4.4
unnamed: H3.4, J4.5
unnamed: H3.5, J4.6
unnamed: H4.2, J1.3
unnamed: H4.3, J1.4
unnamed: H4.4, J1.5
unnamed: H4.5, J1.6
unnamed: H5.2, J3.5
unnamed: H5.3, J3.6
unnamed: H5.4, J2.5
unnamed: H5.5, J2.6
unnamed: IC1.15 (ILIM), R43.2
unnamed: IC1.16 (IMON), R34.2
unnamed: IC2.15 (ILIM), R44.2
unnamed: IC2.16 (IMON), R35.2
unnamed: IC3.15 (ILIM), R45.2
unnamed: IC3.16 (IMON), R37.2
unnamed: IC4.15 (ILIM), R46.2
unnamed: IC4.16 (IMON), R39.2
unnamed: IC5.15 (ILIM), R47.2
unnamed: IC5.16 (IMON), R41.2
unnamed: C4.2, PS1.6 (CB)
unnamed: PS1.4 (FB), R16.1, R17.2
unnamed: C4.1, L1.1, PS1.2 (SW)
unnamed: C6.2, PS2.6 (CB)
unnamed: PS2.4 (FB), R20.1, R22.2
unnamed: C6.1, L2.1, PS2.2 (SW)
unnamed: C10.2, PS3.6 (CB)
unnamed: PS3.4 (FB), R24.1, R25.2
unnamed: C10.1, L3.1, PS3.2 (SW)
unnamed: D1.2, F1.2, Q1.5 (D_1), Q1.6 (D_2), Q1.7 (D_3), Q1.8 (D_4), Q1.9 (D_5), Q1.10 (D_6), Q1.11 (D_7)
unnamed: Q1.4 (G), R26.2, R27.2

Notes on the sheet:
INTERFACE MODULES
DCDC2
DCDC3
R18 sould be removed if MCU installed!
MCU MODULE
POWER CONTROLLER
SENSORS CONNECTORS
R23 sould be removed if MCU installed!
DCDC1
PORT POWER SWITCHES
R19 sould be removed if MCU installed!
INPUT PROTECTION

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
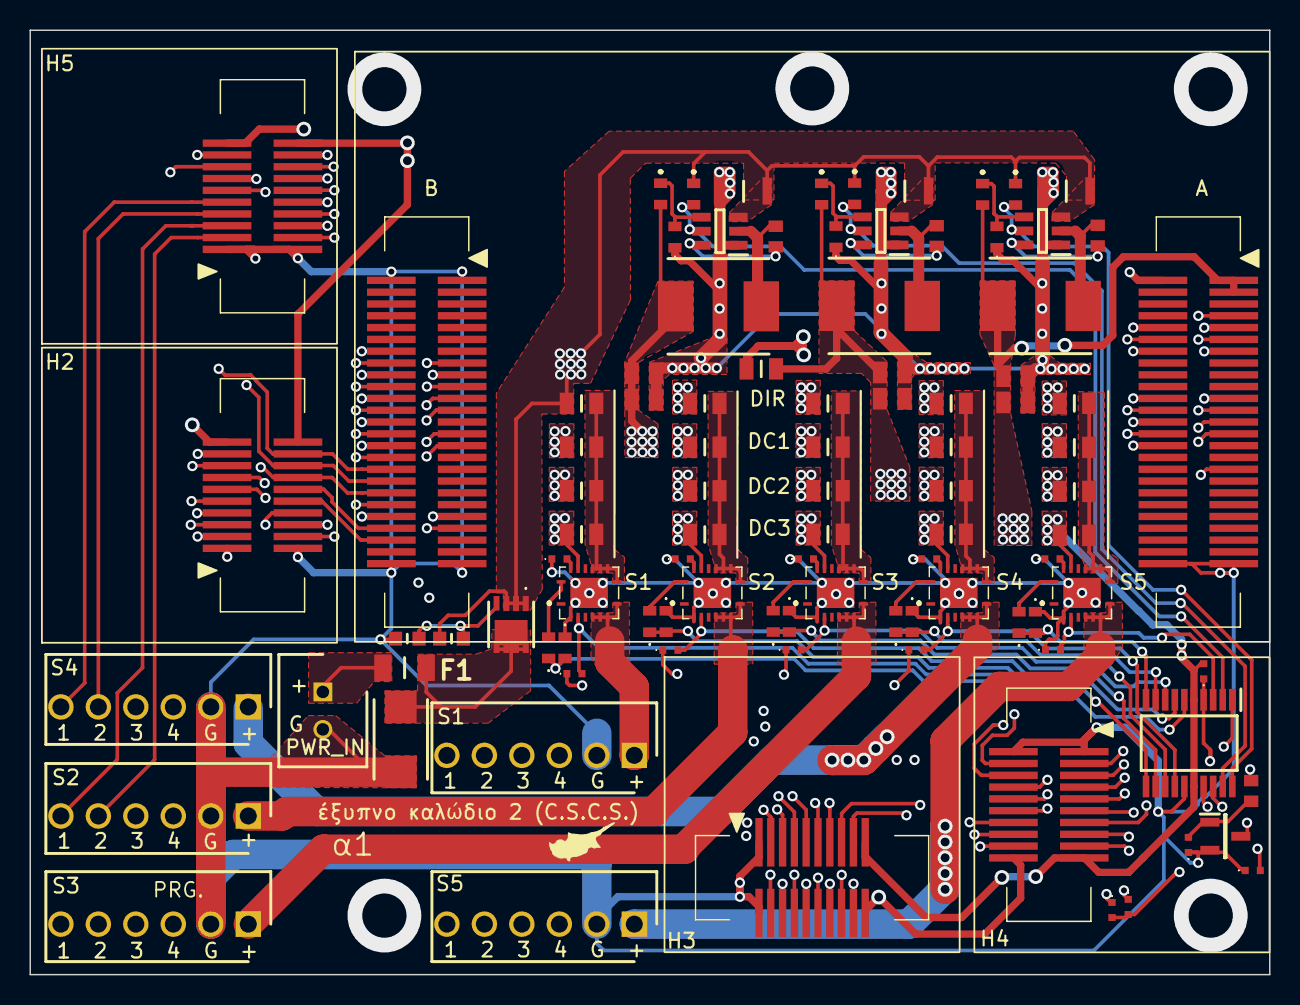
[picture p16: board MB_α1.kicad_pcb from above]

Board: 4 copper layers, 84.0 x 64.0 mm, 97 parts (0 on the bottom side), 111 nets.

Other parts of the board:
C13: C0603C104K5RAC3121; CAPC1608X95N
Q2: IRLML6244TRPBF; SOT95P237X112-3N
R49: ERJ2RKF1003X; ERJ2RKD1004X

Their connections:
unnamed: C13.1, Q2.1 (G), R49.2
