Cyprus-Subsea/Smart-Cable-2-Hardware/(commit log)

2022-11-21 init commit
    [MB_V1.kicad_pcb, MB_V1.kicad_sch]
2023-05-30 MB_V1 MCU_V1
    [MB_V1.kicad_pcb, MB_V1.kicad_sch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]
2023-05-30 MB_V1 changed
    [MB_V1.kicad_pcb]
2023-06-05 MB V1 finished
    [MB_V1.kicad_pcb, MB_V1.kicad_sch]
2023-06-06 MB V1 finished again
    [MB_V1-B_Cu.gbr, MB_V1-B_Mask.gbr, MB_V1-B_Paste.gbr, MB_V1-B_Silkscreen.gbr, MB_V1-Edge_Cuts.gbr, MB_V1-F_Cu.gbr, MB_V1-F_Mask.gbr, MB_V1-F_Paste.gbr]
2023-06-06 Versions names changed to greek
    [MB_V1-B_Cu.gbr, MB_V1-B_Mask.gbr, MB_V1-B_Paste.gbr, MB_V1-B_Silkscreen.gbr, MB_V1-Edge_Cuts.gbr, MB_V1-F_Cu.gbr, MB_V1-F_Mask.gbr, MB_V1-F_Paste.gbr]
2023-06-06 RS232-2 updated
    [PINOUTS.xlsx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]
2023-06-07 IMU added
    [IMU_α1-B_Cu.gbr, IMU_α1-B_Mask.gbr, IMU_α1-B_Paste.gbr, IMU_α1-B_Silkscreen.gbr, IMU_α1-Edge_Cuts.gbr, IMU_α1-F_Cu.gbr, IMU_α1-F_Mask.gbr, IMU_α1-F_Paste.gbr]
2023-06-07 DIRECT I2C added
    [DIRECT_I2C_α1-B_Cu.gbr, DIRECT_I2C_α1-B_Mask.gbr, DIRECT_I2C_α1-B_Paste.gbr, DIRECT_I2C_α1-B_Silkscreen.gbr, DIRECT_I2C_α1-Edge_Cuts.gbr, DIRECT_I2C_α1-F_Cu.gbr, DIRECT_I2C_α1-F_Mask.gbr, DIRECT_I2C_α1-F_Paste.gbr]
2023-06-07 MCU α2 added
    [MCU_α2.kicad_pcb, MCU_α2.kicad_sch]
